Make-A-Pede/Make-A-Pede-Website/README.md

# Make-A-Pede-Website
Files for the Make-A-Pede website: http://makeapede.com
