Make-A-Pede/Make-A-Pede-Website/deck.js-latest/themes/style/metal-tile-d.jpg

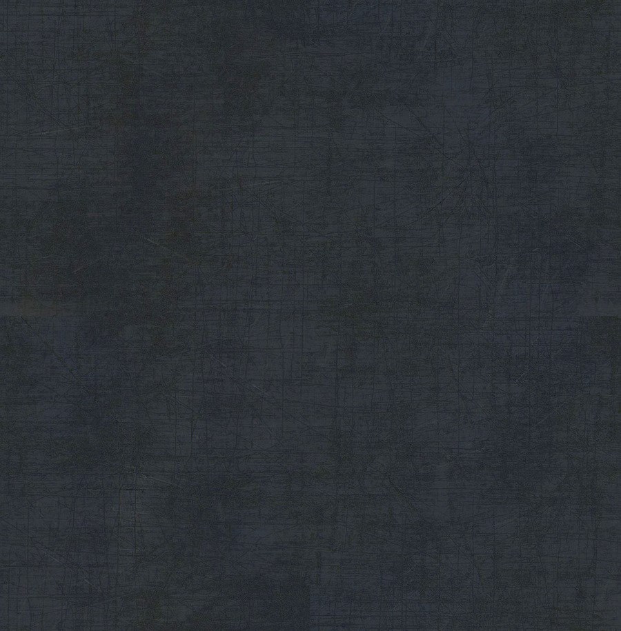
deck.js-latest/themes/style/metal-tile-d.jpg
