Make-A-Pede/Make-A-Pede-Website/img/arduino-community.png

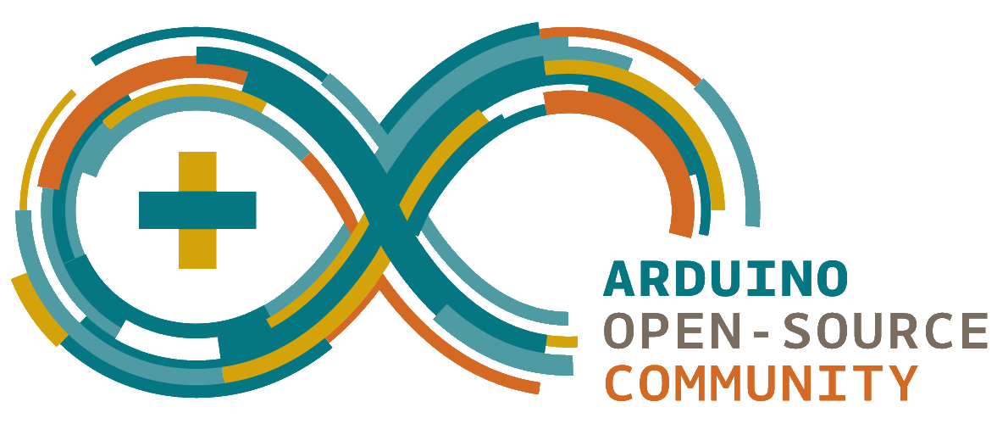
img/arduino-community.png
