Make-A-Pede/Make-A-Pede-Website/img/electronics101.png

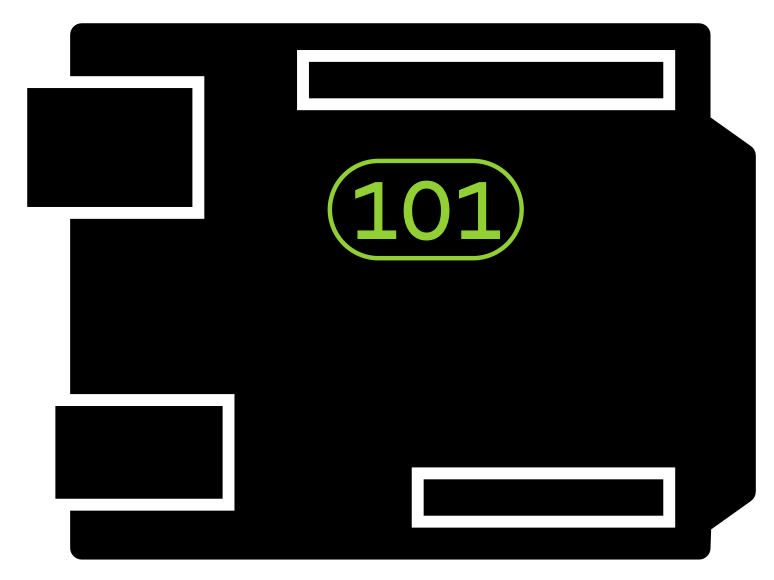
img/electronics101.png
