Make-A-Pede/Make-A-Pede-Website/img/hackadayio.png

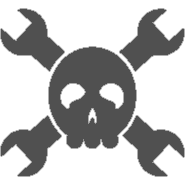
img/hackadayio.png
