Make-A-Pede/Make-A-Pede-Website/img/IMG_20170712_092057252_edited2.jpg

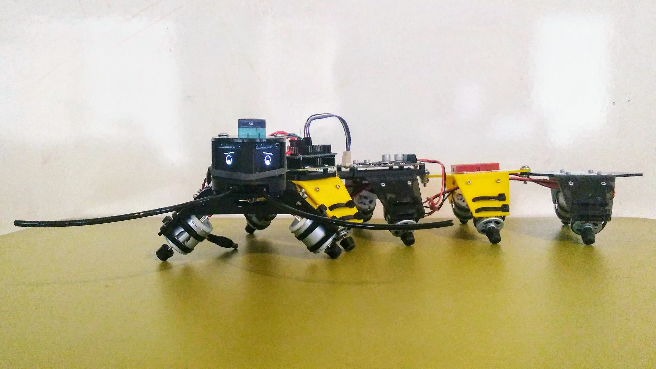
img/IMG_20170712_092057252_edited2.jpg
