Make-A-Pede/Make-A-Pede-Website/img/IMG_20170712_092200675_edited_w.jpg

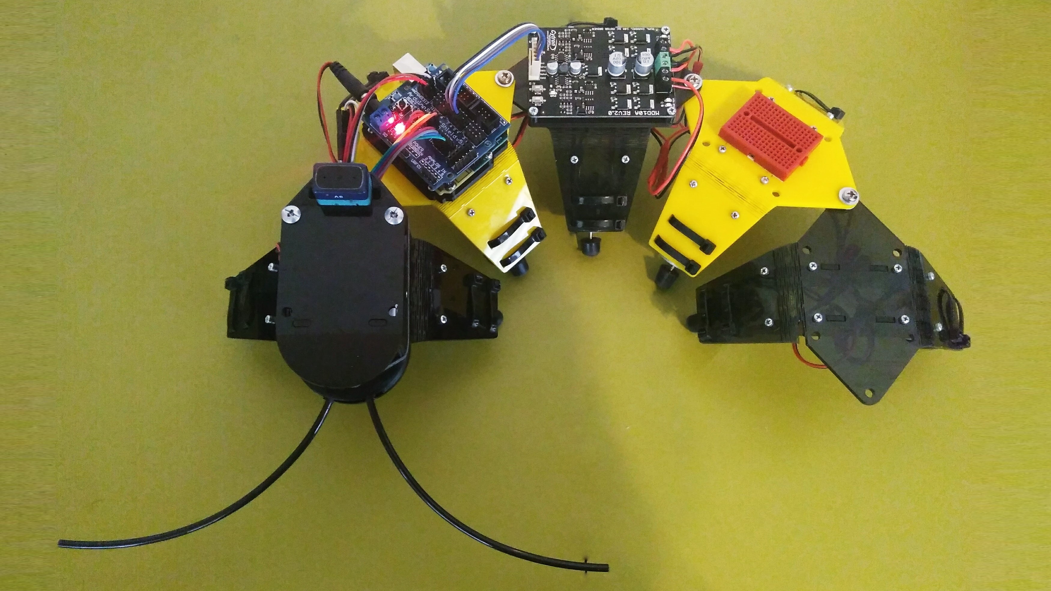
img/IMG_20170712_092200675_edited_w.jpg
