Make-A-Pede/Make-A-Pede-Website/img/map-mascot-dg.png

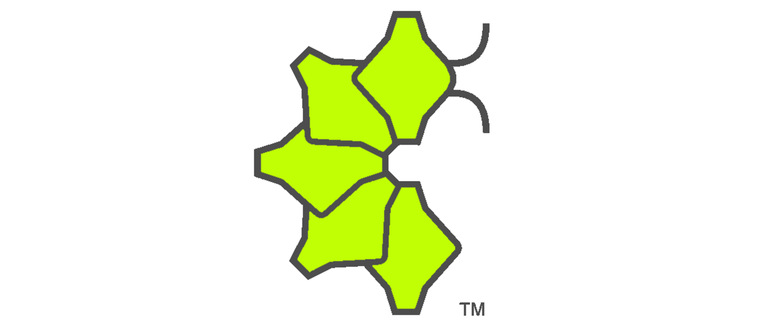
img/map-mascot-dg.png
