Make-A-Pede/Make-A-Pede-Website/img/overview3.png

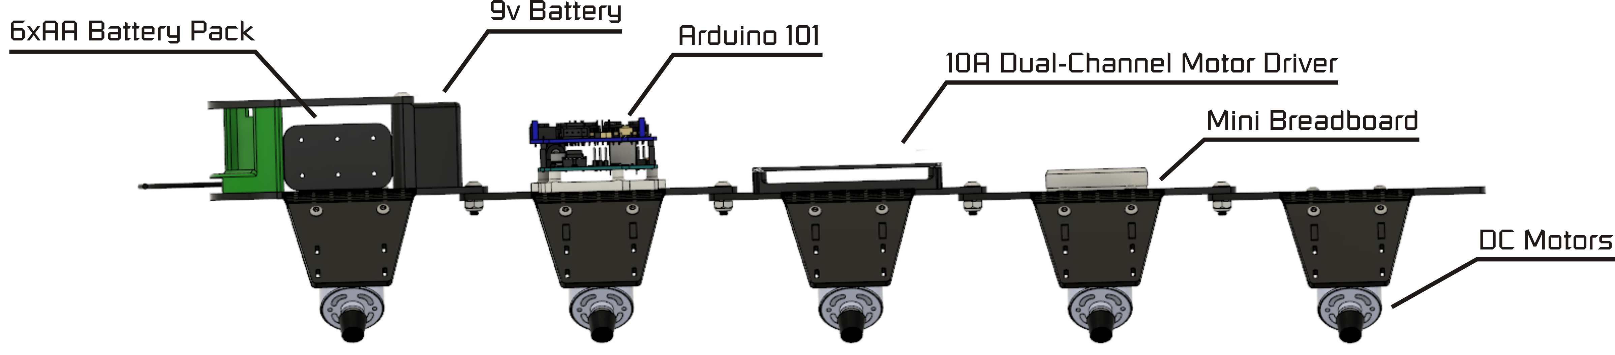
img/overview3.png
