Make-A-Pede/Make-A-Pede-Website/img/programming.png

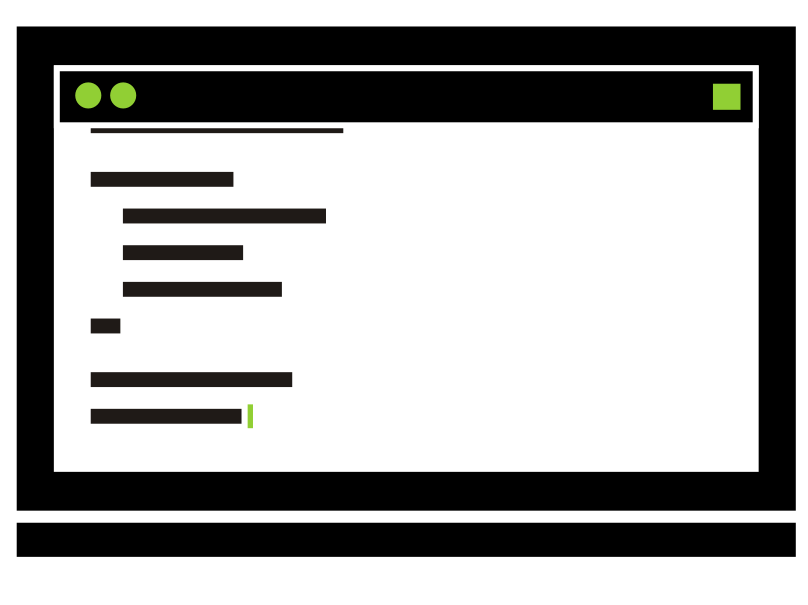
img/programming.png
