Make-A-Pede/Make-A-Pede-Website/img/render3.jpg

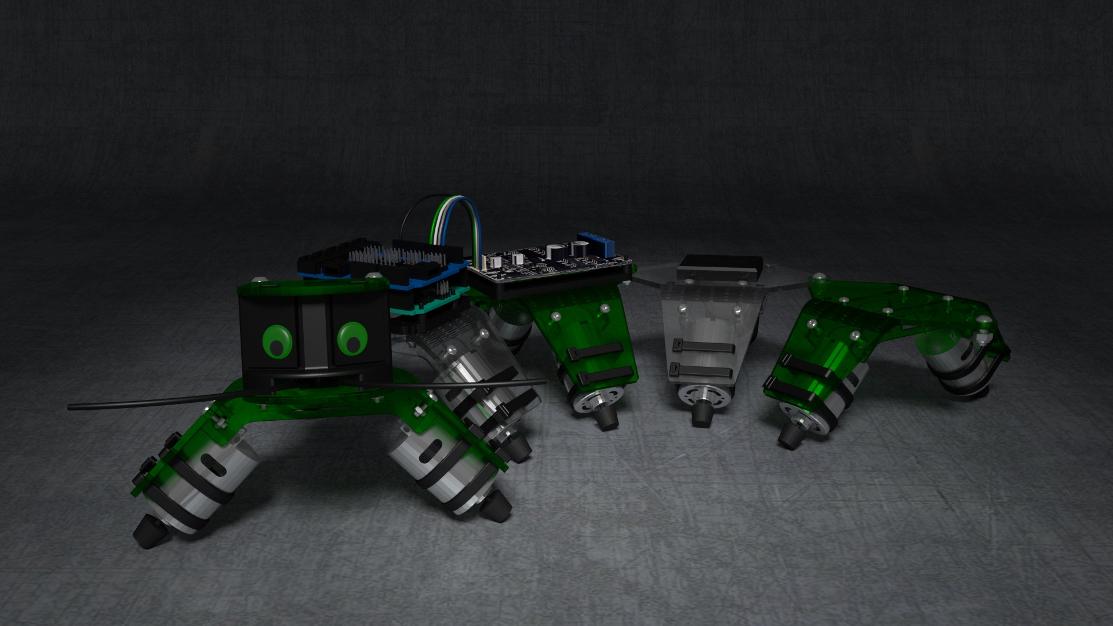
img/render3.jpg
