Make-A-Pede/Make-A-Pede-Website/img/render.jpg

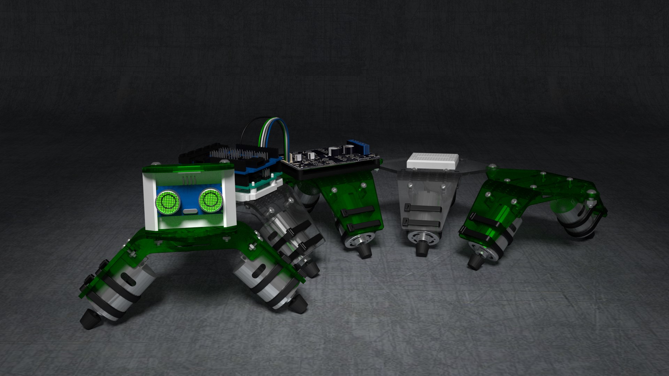
img/render.jpg
