Make-A-Pede/Make-A-Pede-Website/plans/MaP-Controller-v1.1.0.jpg

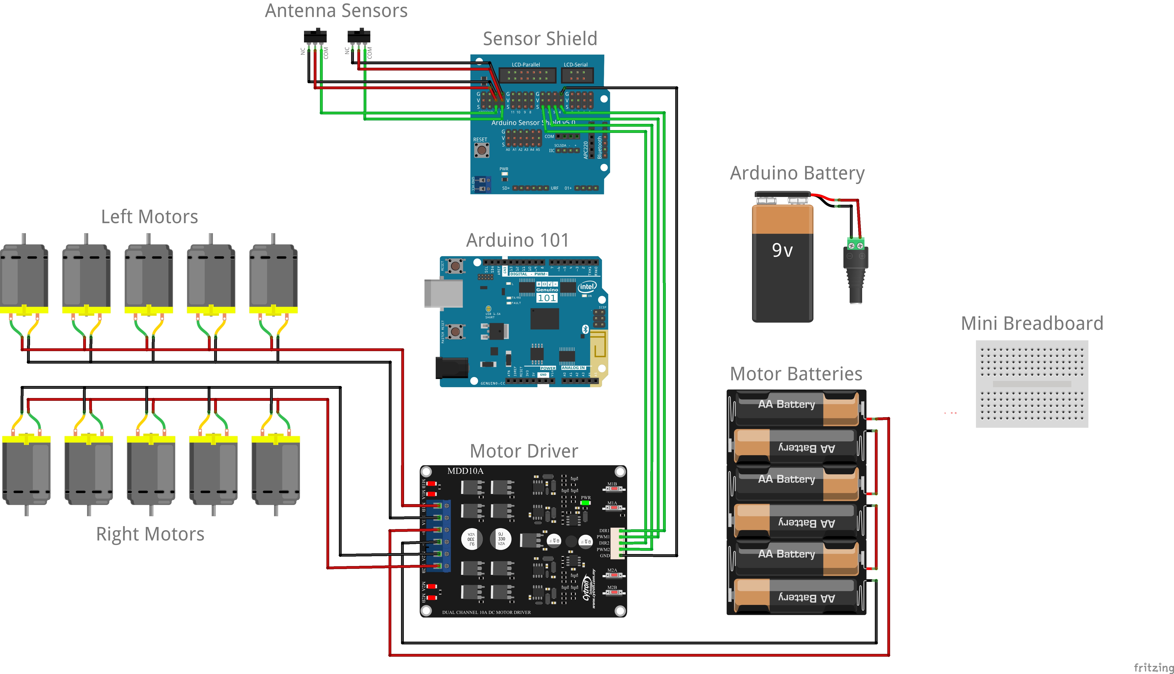
plans/MaP-Controller-v1.1.0.jpg
