Make-A-Pede/Make-A-Pede-Website/starthere/img/app.jpg

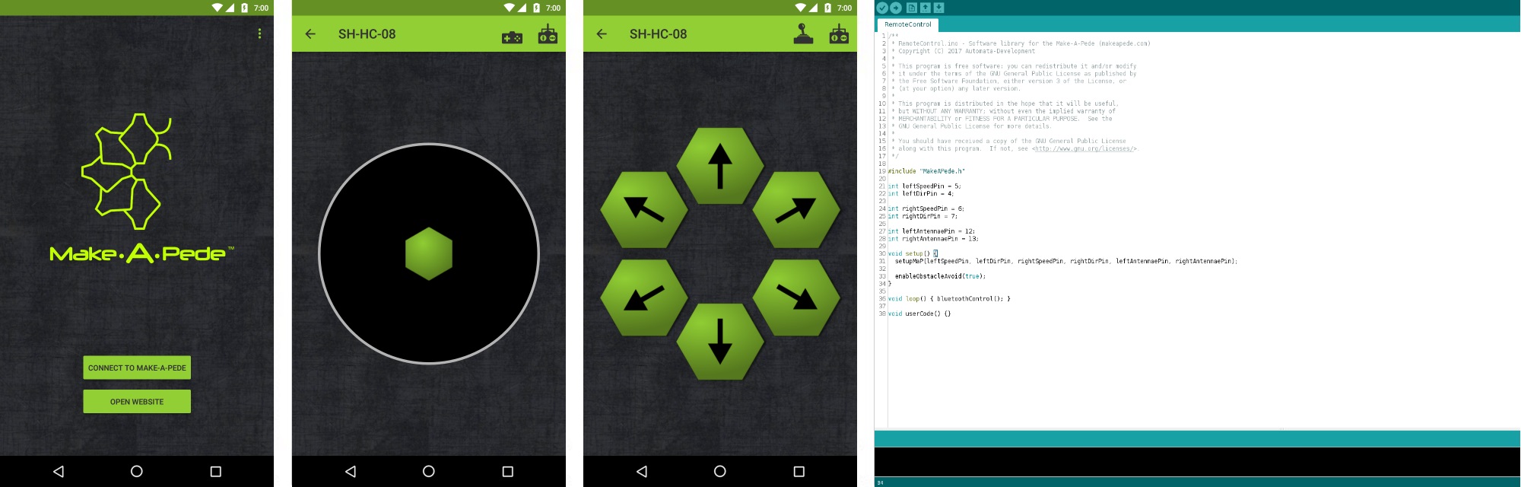
starthere/img/app.jpg
