Make-A-Pede/Make-A-Pede-Website/starthere/img/arrows.png

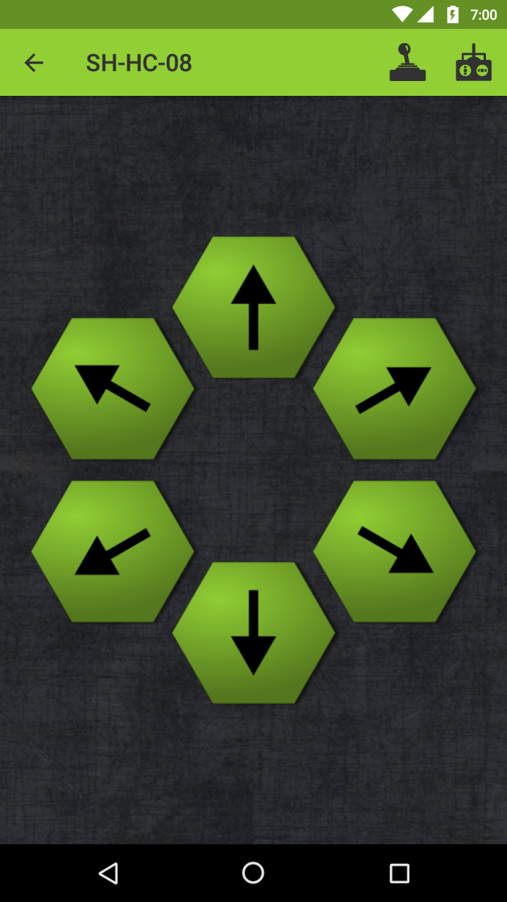
starthere/img/arrows.png
