Make-A-Pede/Make-A-Pede-Website/starthere/img/headsegment.jpg

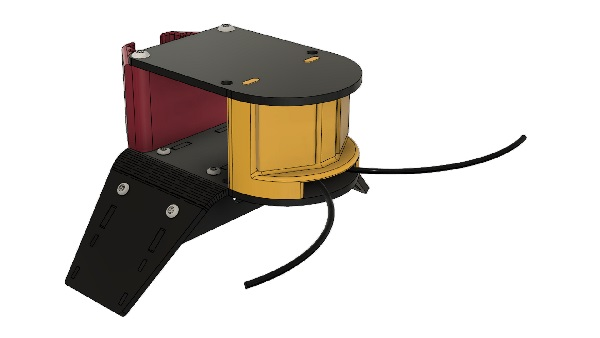
starthere/img/headsegment.jpg
