Make-A-Pede/Make-A-Pede-Website/starthere/img/home.png

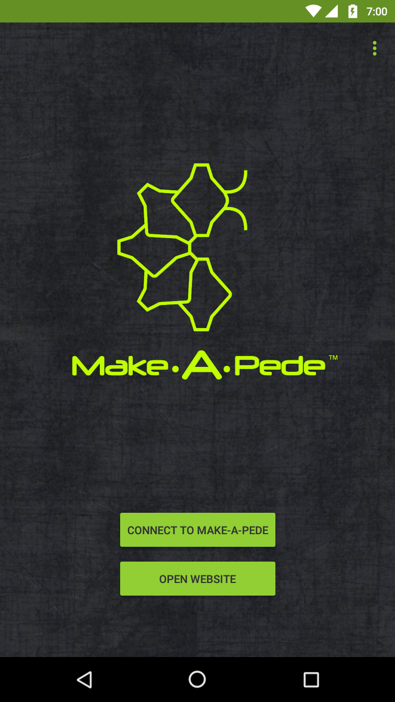
starthere/img/home.png
