Make-A-Pede/Make-A-Pede-Website/starthere/img/IMG_20170526_203459872_edited.jpg

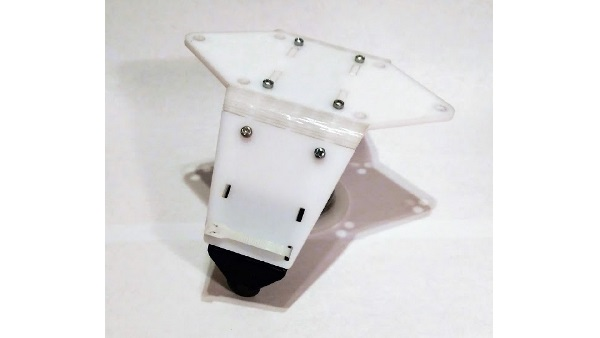
starthere/img/IMG_20170526_203459872_edited.jpg
