Make-A-Pede/Make-A-Pede-Website/starthere/img/IMG_20170526_203523421_HDR_edited.jpeg

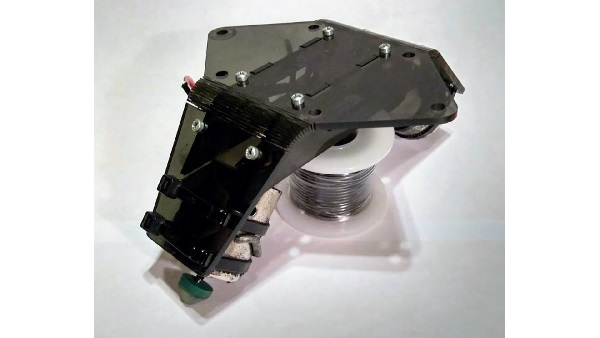
starthere/img/IMG_20170526_203523421_HDR_edited.jpeg
