Make-A-Pede/Make-A-Pede-Website/starthere/img/IMG_20170531_193209461_edited.jpg

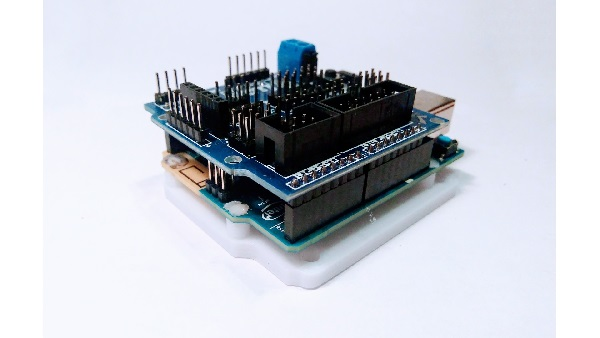
starthere/img/IMG_20170531_193209461_edited.jpg
