Make-A-Pede/Make-A-Pede-Website/starthere/img/IMG_20170531_201020182_edited.jpg

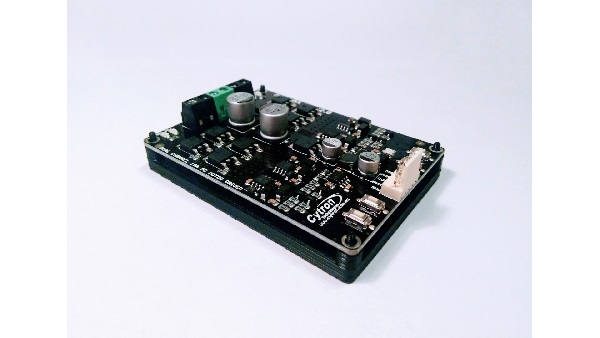
starthere/img/IMG_20170531_201020182_edited.jpg
