Make-A-Pede/Make-A-Pede-Website/starthere/img/joystick.png

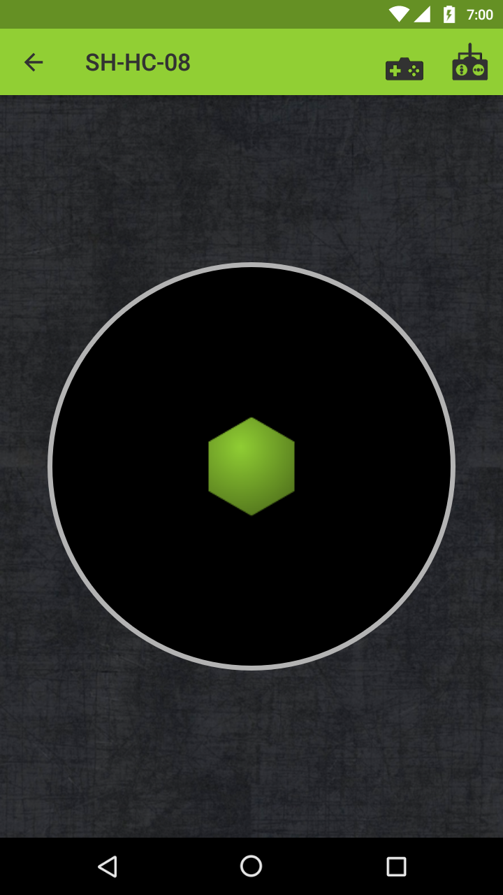
starthere/img/joystick.png
