Make-A-Pede/Make-A-Pede-Website/starthere/img/map-arduino.png

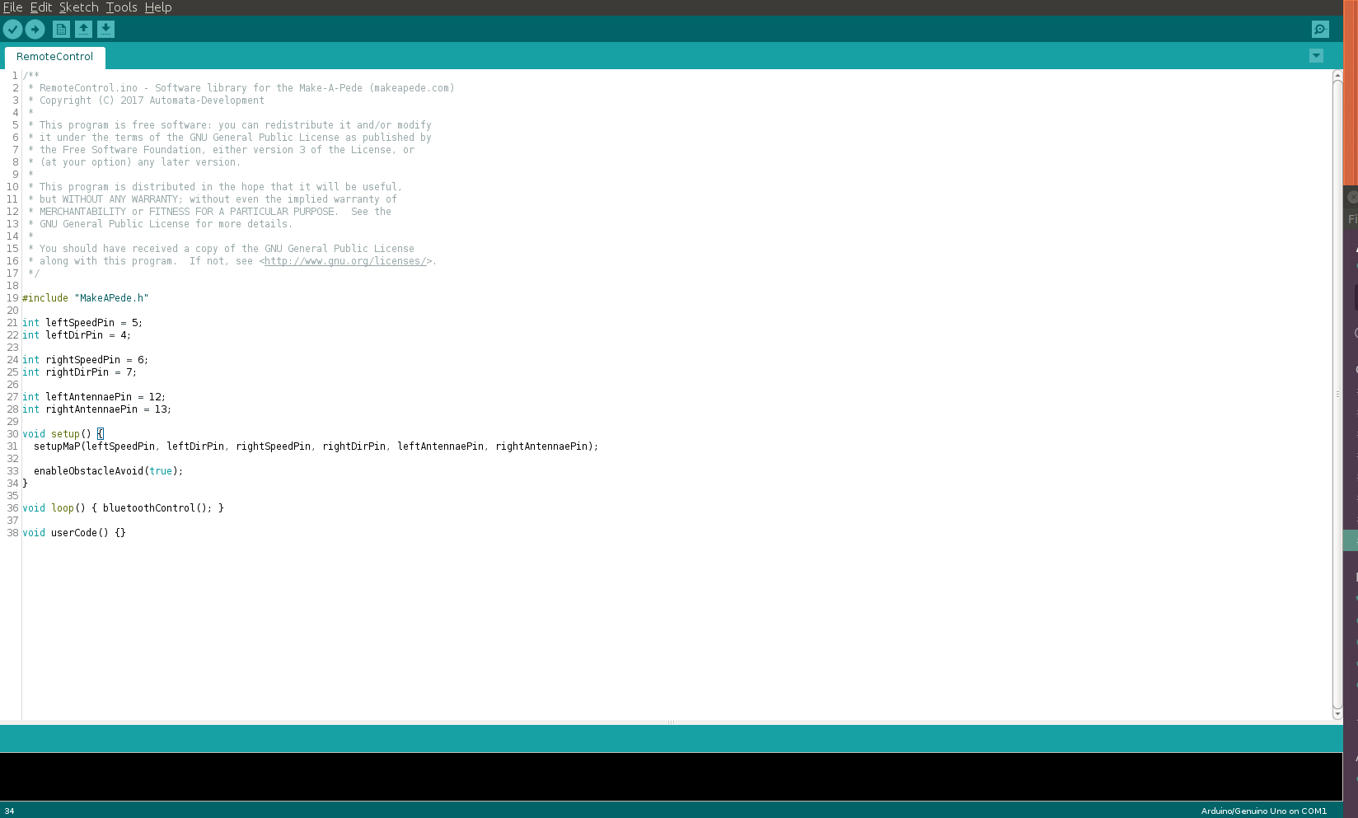
starthere/img/map-arduino.png
