Make-A-Pede/Make-A-Pede-Website/starthere/img/sensormounting.jpg

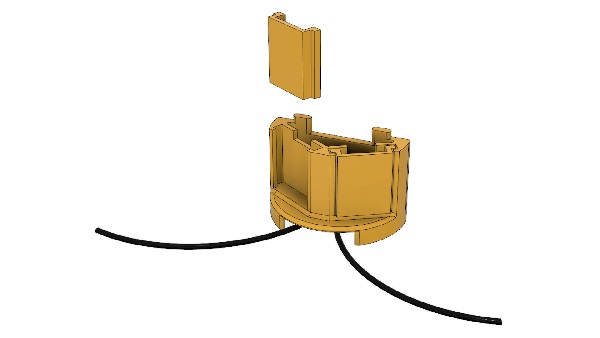
starthere/img/sensormounting.jpg
