Make-A-Pede/Make-A-Pede-Website/buildyourownrobot/index.html

# Home

- About
- Why
- Getting Started
- Going Further

# Start Here

- Get the Parts
- Build the Chassis
- Wire the Electronics
- Write a Program

# Plans

- Bill of Materials
- CAD Files
- Schematics
- Code Library

# Tutorials

- Building
- Programming
- Projects

# Store (http://store.makeapede.com/)

# Build Your Own Robot

Instructions and resources for the Build Your Own Robot class offered at the 2019 AFHE Convention. When completed, this robot will autonomously drive around and avoid obstacles.

Building Instructions

Programming Instructions

GitHub Repository (https://github.com/Make-A-Pede/AFHE-Beginning-Robotics-Workshop)

Click on the bars in the upper right corner to show all videos in playlist

### Updates

7/19/2019

- When mounting the servo horn, the small screws used have been known to break. You can avoid this by only putting the screws in about 1/2 of the way. If the screws do break, you can add superglue to hold the parts in place.
- If one of your robot's wheels runs backwards when the robot is first turned on, you can swap the black and red wires going into the motor driver that are coming from that motor.
- To turn on your robot, install all of the batteries then plug in the Arduino. It will immediately start running the program you loaded. To turn off the robot, unplug the Arduino, then remove one of the batteries.
- This kit does not include the electronic components needed for the robot to be controlled using our app. However, this is a low cost upgrade you can do yourself and we will be posting more details here soon.

7/30/2019

Bluetooth remote control can be added to your robot using an HC-08 bluetooth module. These modules are included with the Make-A-Pede kit or can be purchased from Amazon (e.g. DSD TECH SH-HC-08 Bluetooth Module (https://www.amazon.com/DSD-TECH-SH-HC-08-Transceiver-Compatible/dp/B01N4P7T0H/)).

Adding Bluetooth Remote Control

1. Download the remote control program here
2. Load the program on your robot using the same procedure as shown in the videos/instructions above
3. After the program is loaded, attach the Bluetooth module to your robot as shown below.
4. Follow the instructions in this video to set up the app: Make-A-Pede Phone Connection and First Run (https://youtu.be/nE9ZWOvrAX8?t=70)
5. You will need to disconnect the Bluetooth module when loading a new program

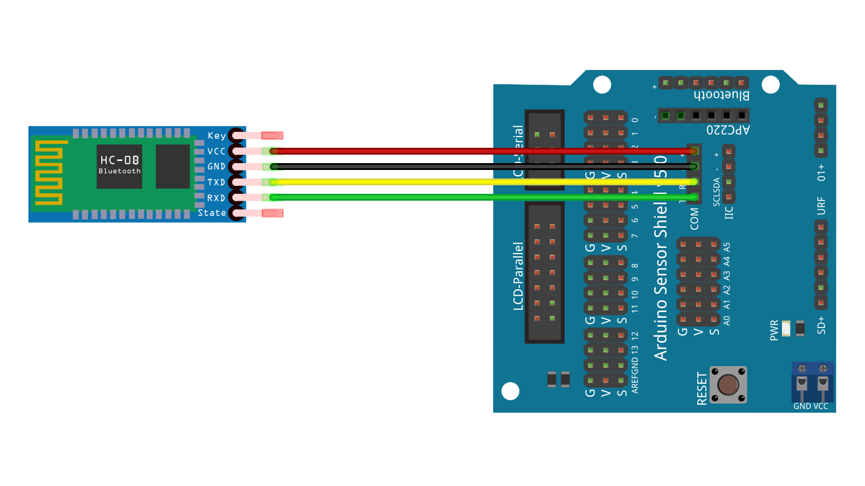
[picture p25: buildyourownrobot/bluetooth-wiring.png]
Bluetooth module wiring diagram


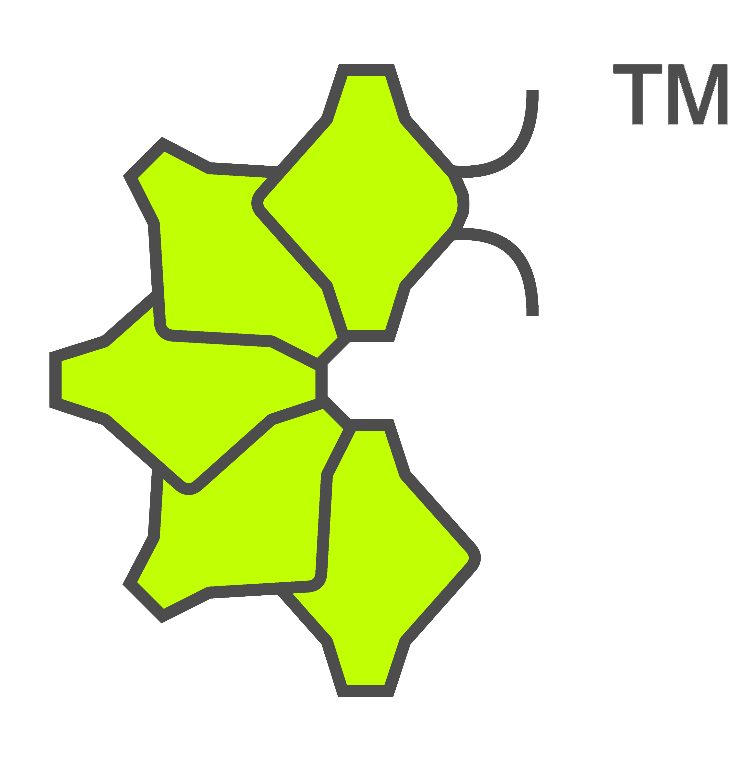
[picture p26: img/MaP-Logo-Icon-LgTM-DG.png]
Make-A-Pede Logo


(https://www.youtube.com/channel/UCuvQ2hq8uN-BKy3SVHprXtA) (https://www.facebook.com/makeapede/) (https://twitter.com/makeapede)

© 2016-2018 Automata Development
