Make-A-Pede/Make-A-Pede-Website/tutorials/index.html

# Home

- About
- Why
- Getting Started
- Going Further

# Start Here

- Get the Parts
- Build the Chassis
- Wire the Electronics
- Write a Program

# Plans

- Bill of Materials
- CAD Files
- Schematics
- Code Library

# Tutorials

- Building
- Programming
- Projects

# Store (http://store.makeapede.com/)

# Building

### Chassis Assembly Tutorials

Click on the bars in the upper right corner to show all videos in playlist

Segment Assembly Instructions

Head Segment Assembly Instructions

Segment Connection Instructions

### Electronics Installation Tutorials

Click on the bars in the upper right corner to show all videos in playlist

Motor Installation Instructions

Module Assembly Instructions

Final Wiring Instructions

Wiring Harness Assembly Instructions

# Programming

### Software Setup Tutorials

Click on the bars in the upper right corner to show all videos in playlist

Library and Remote Control Program Installation Instructions

Phone Connection and First Run Instructions

### Additional Resources

Arduino IDE (Windows) (https://www.arduino.cc/en/Guide/Windows)

Arduino IDE (mac OS) (https://www.arduino.cc/en/Guide/MacOSX)

GitHub Repository (https://github.com/Make-A-Pede/Make-A-Pede-Arduino-Library)

Android App

iOS App

# Projects

### Sound Sensor

Difficulty:     

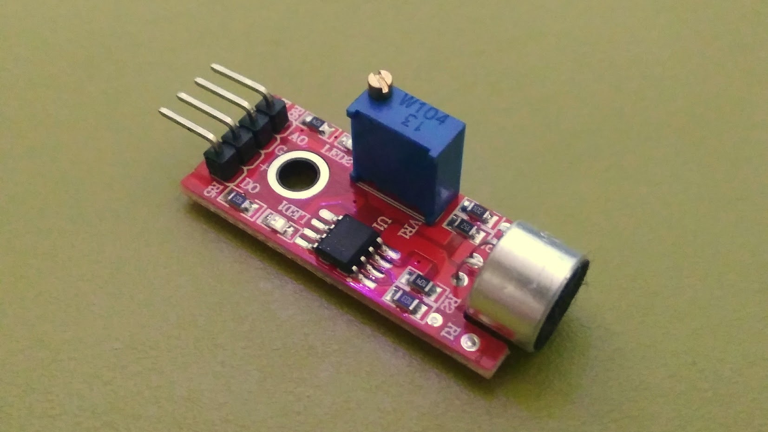
[picture p27: tutorials/projects/IMG_20170722_152200550-01[1].jpeg]


View Instructions

### IR Distance Sensor

Difficulty:     

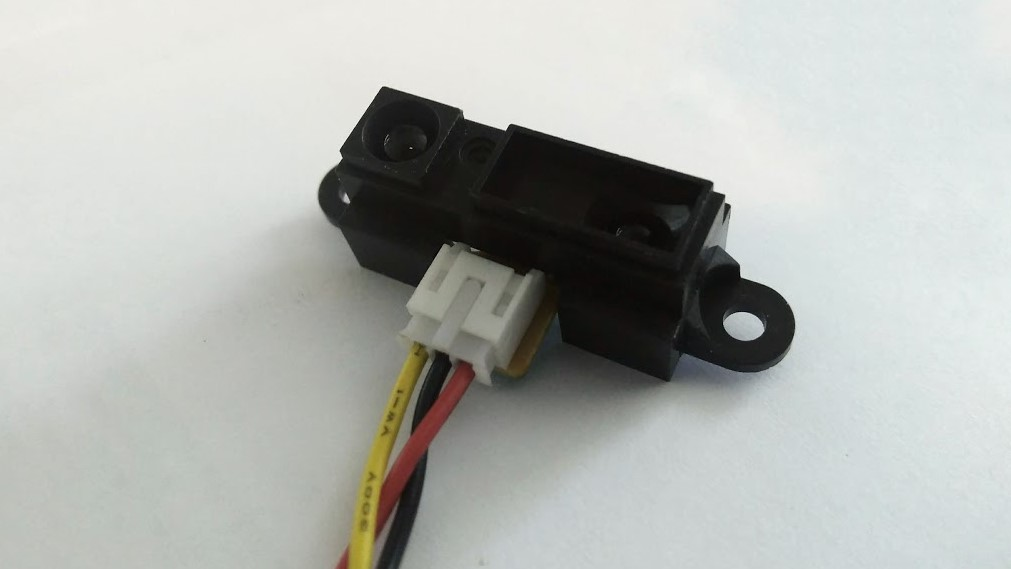
[picture p28: tutorials/projects/IMG_20180606_174354819-01.jpg]


View Instructions

### RGB LED

Difficulty:     

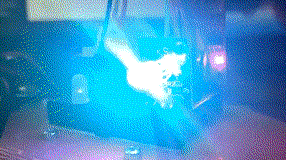
[picture p29: tutorials/projects/2017-07-22_15-47-03.gif]


View Instructions

### PIR Sensor

Difficulty:     

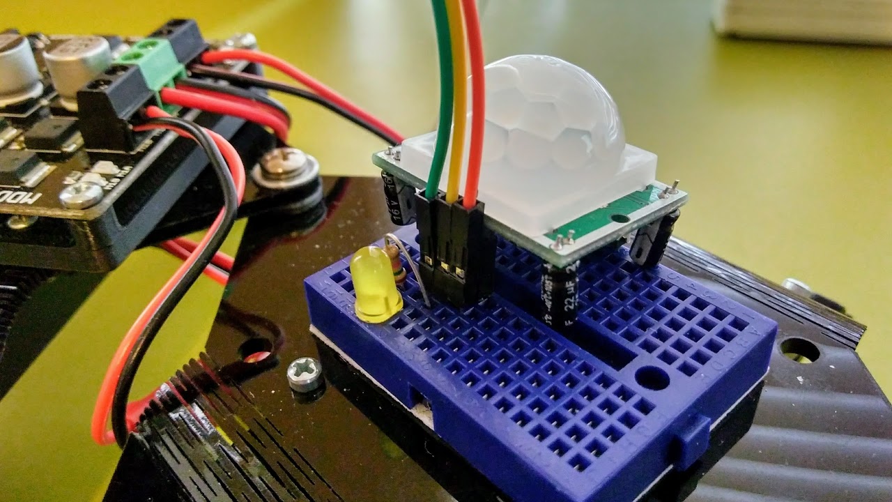
[picture p30: tutorials/projects/IMG_20170719_155303936_HDR[2].jpg]


View Instructions

### OLED Eyes

Difficulty:     

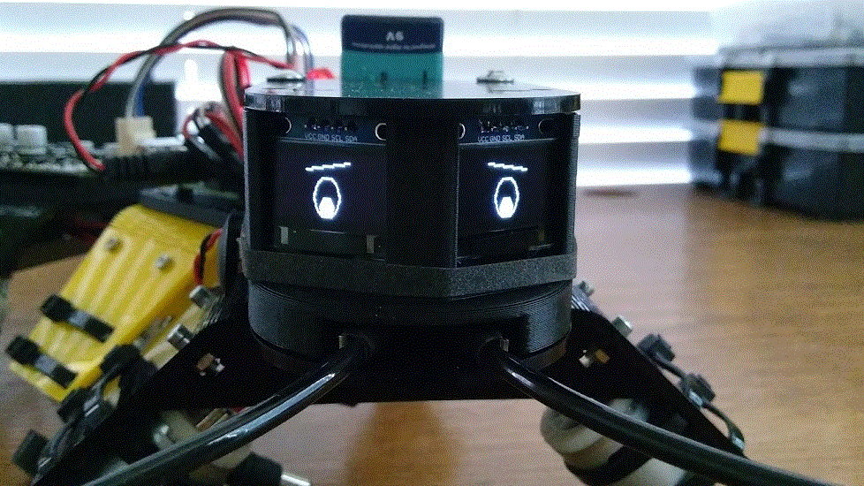
[picture p31: tutorials/projects/blinking-gif-optimized.gif]


View Instructions

### Color Sensor

Difficulty:     

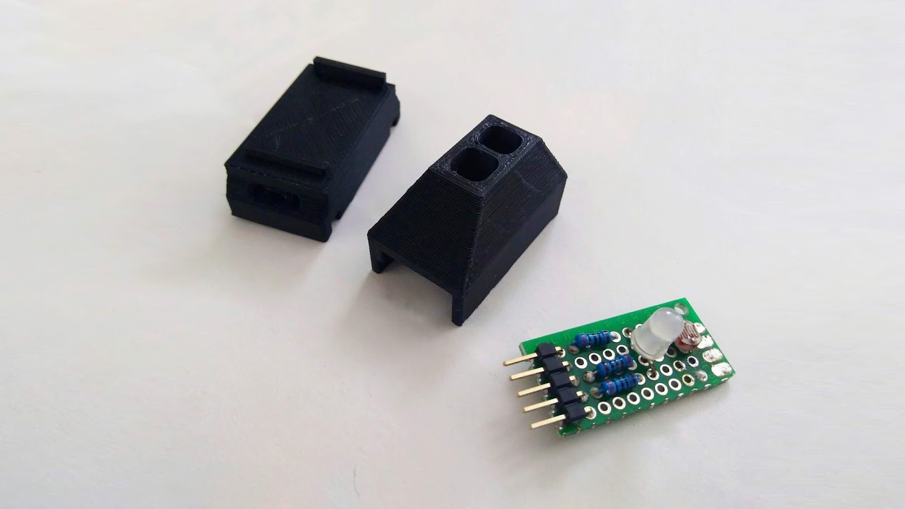
[picture p32: tutorials/projects/IMG_20180607_110257728-01.jpeg]


View Instructions

Make-A-Pede Logo

(https://www.youtube.com/channel/UCuvQ2hq8uN-BKy3SVHprXtA) (https://www.facebook.com/makeapede/) (https://twitter.com/makeapede)

© 2016-2018 Automata Development
