Make-A-Pede/Make-A-Pede-Website/tutorials/library-installation.html

# Installing the Make-A-Pede Arduino Library

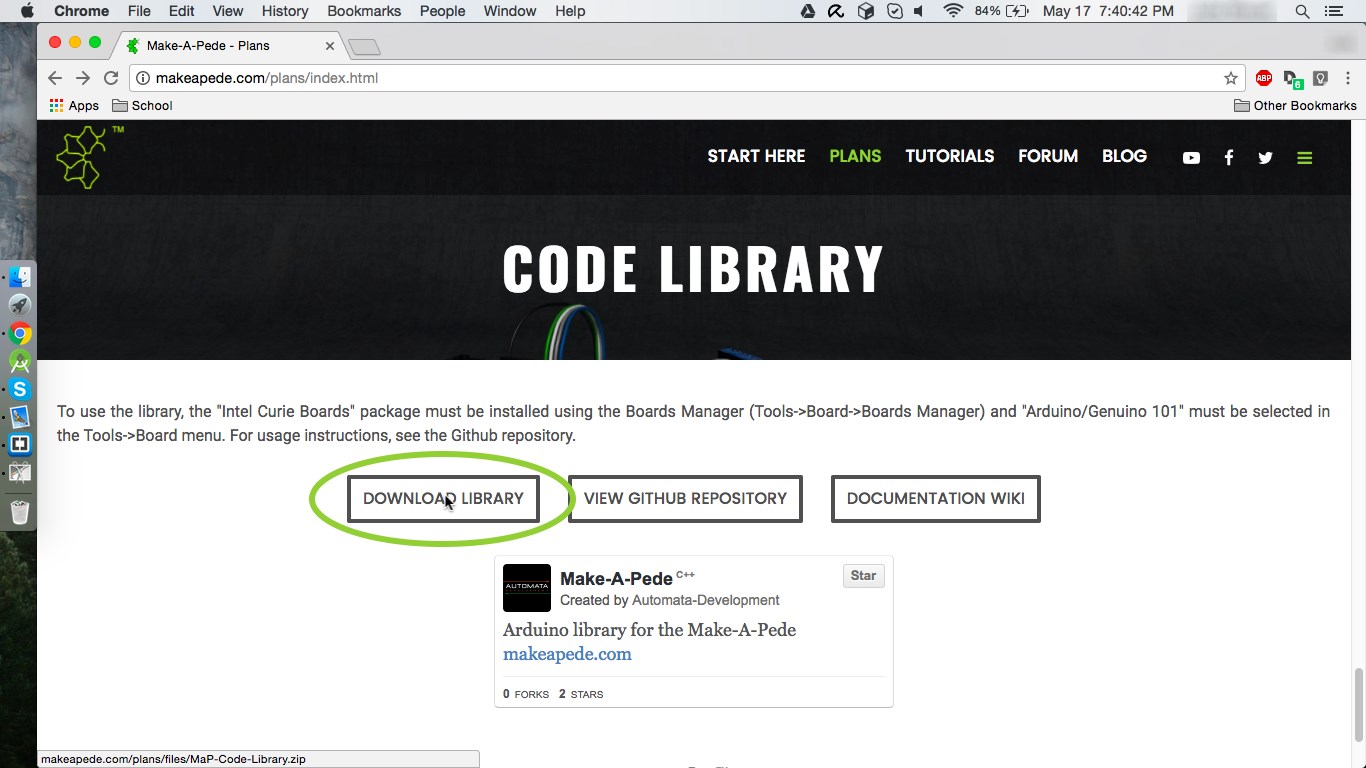
[picture p33: tutorials/installation-screenshots/9.jpg]


Download the library .zip file from the Plans page on makeapede.com and extract it.

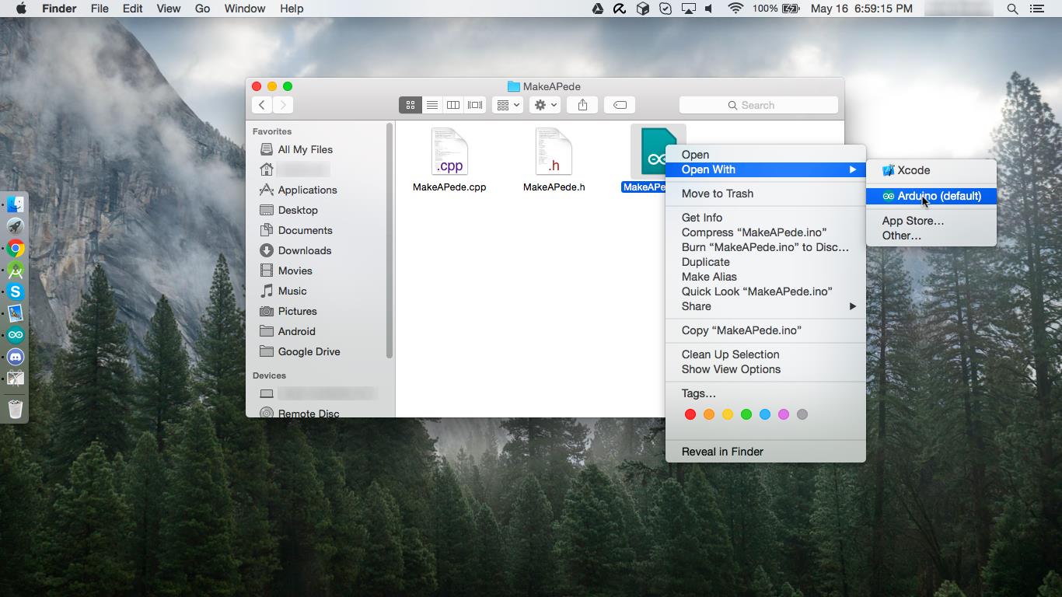
[picture p34: tutorials/installation-screenshots/3.jpg]


Open the “MakeAPede” folder and open “MakeAPede.ino” using the Arduino IDE.

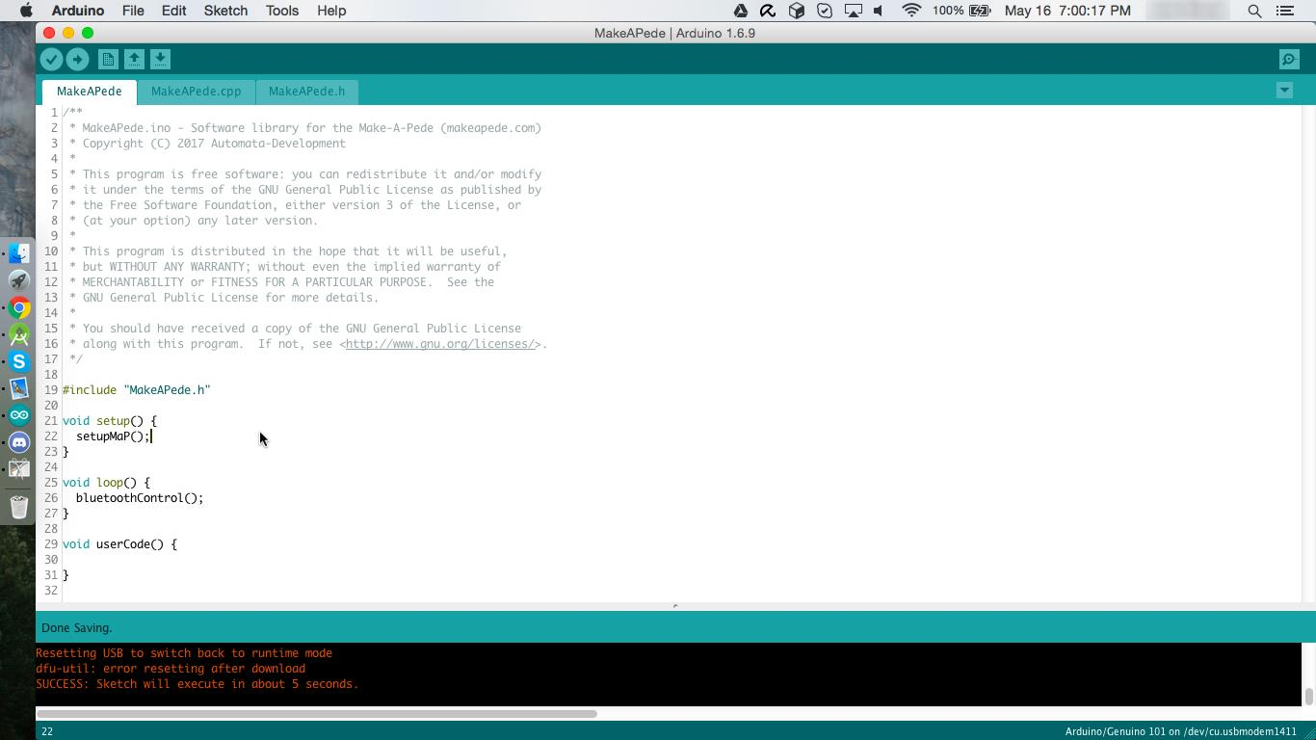
[picture p35: tutorials/installation-screenshots/4.jpg]


The project will open in the Arduino IDE. The main code will be under the “MakeAPede” tab.

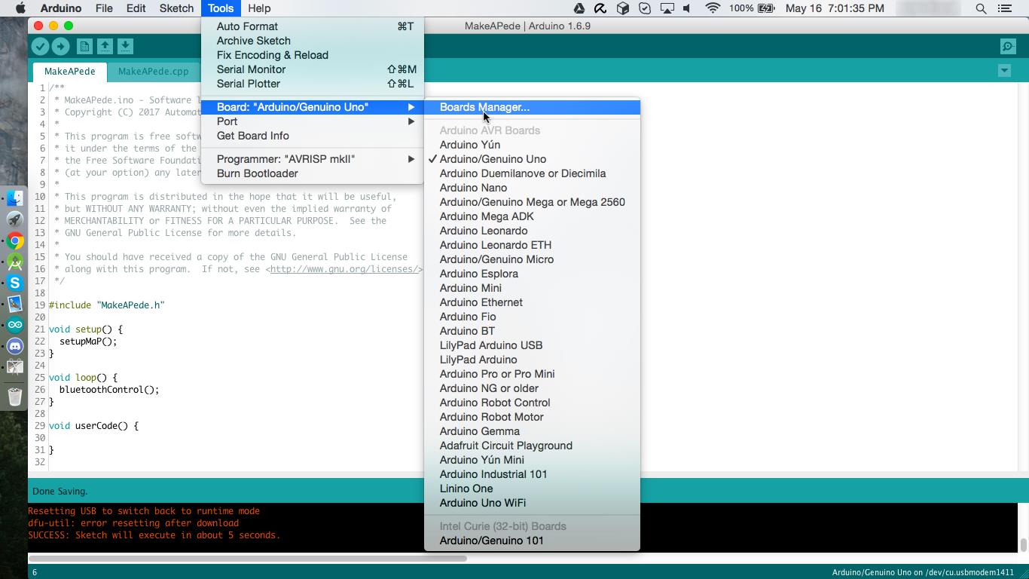
[picture p36: tutorials/installation-screenshots/5.jpg]


Go to the Tools->Board menu and open the Boards Manager.

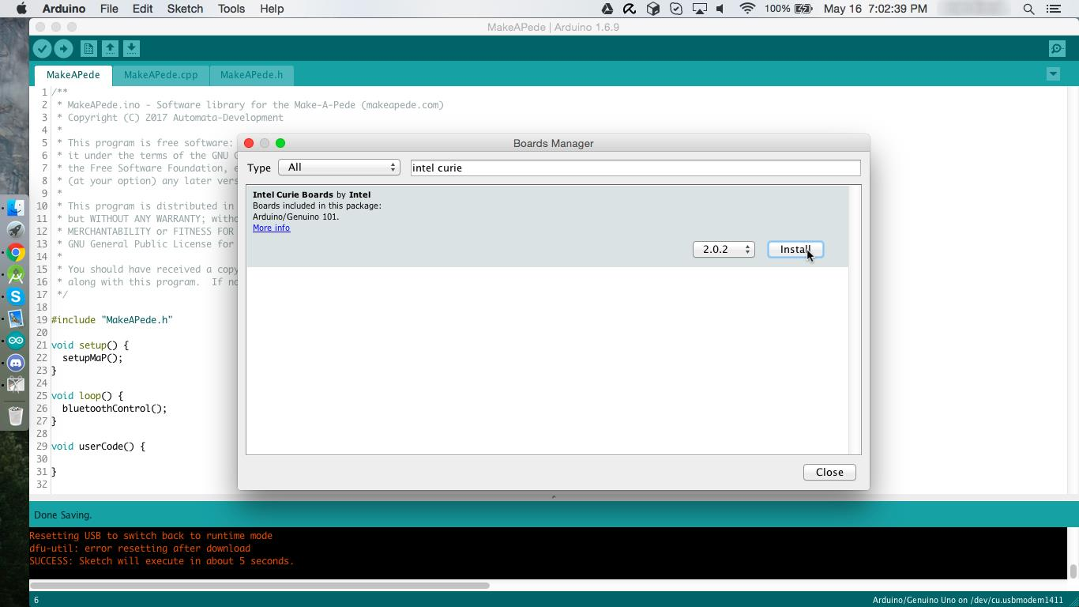
[picture p37: tutorials/installation-screenshots/6.jpg]


Search for and install the “Intel Curie Boards” package.

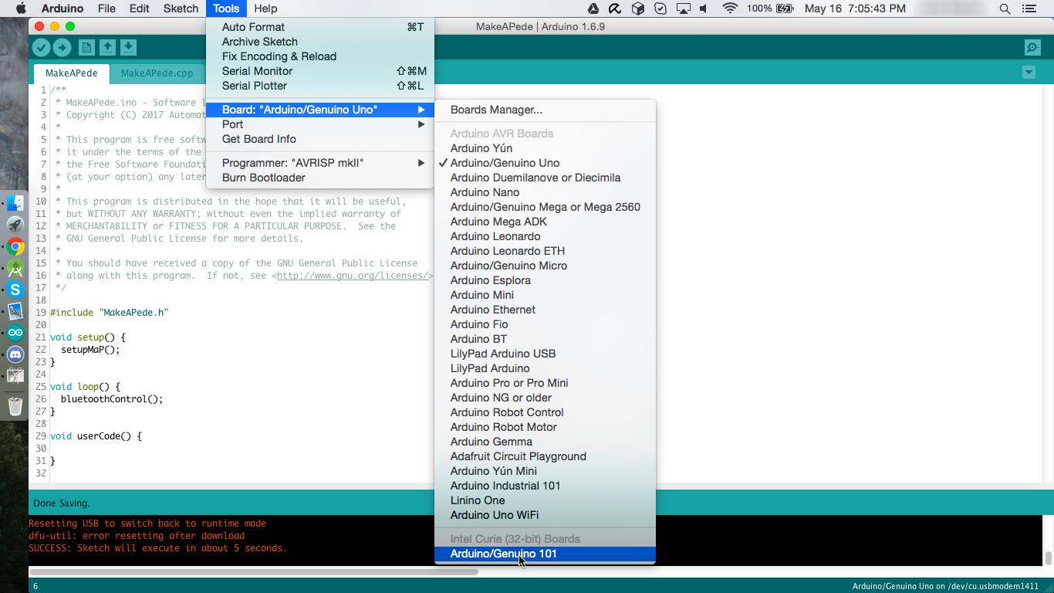
[picture p38: tutorials/installation-screenshots/7.jpg]


Once the boards package is installed, select “Arduino/Genuino 101” from the Tools->Board menu.

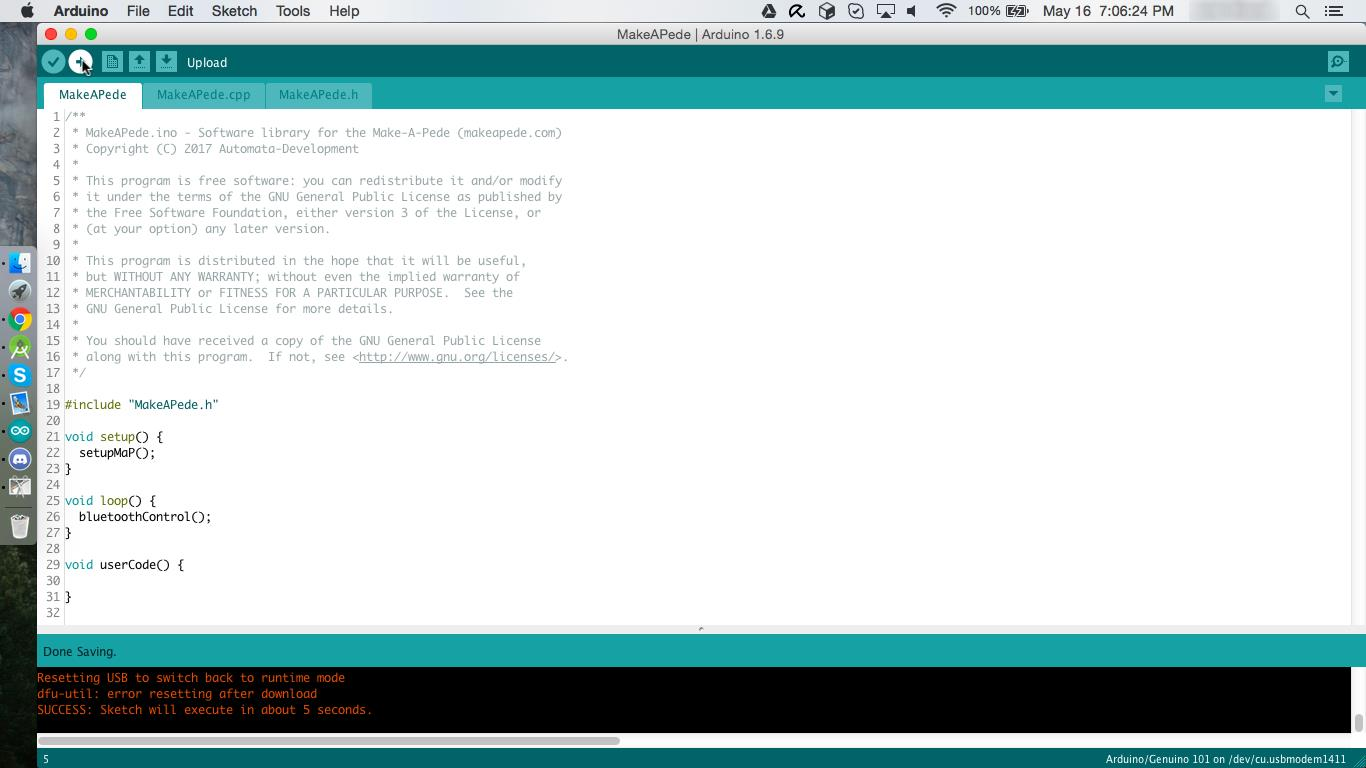
[picture p39: tutorials/installation-screenshots/8.jpg]


You can now click the upload button in the upper left corner to run the code on your robot.

← →

/
