Make-A-Pede/Make-A-Pede-Website/tutorials/projects/Project-Tutorial-Sound-Sensor.pdf

## Adding a Sound Sensor

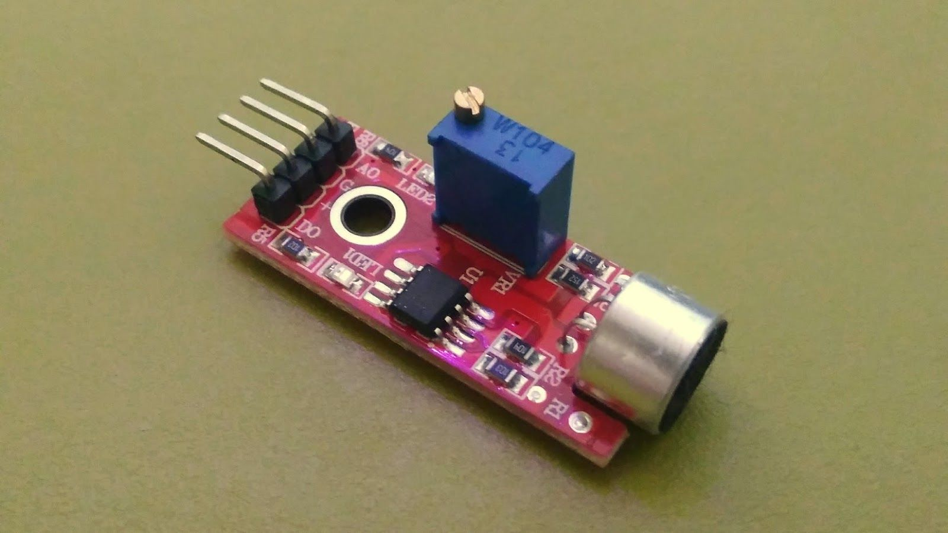
[picture p61: figure]

Parts Required:

1 - Assembled Make-A-Pede
1 - Electret Mic Breakout Board 3 - M-F Jumper Wires

### Wiring

Connect the sensor to your Make-A-Pede using the circuit shown below.

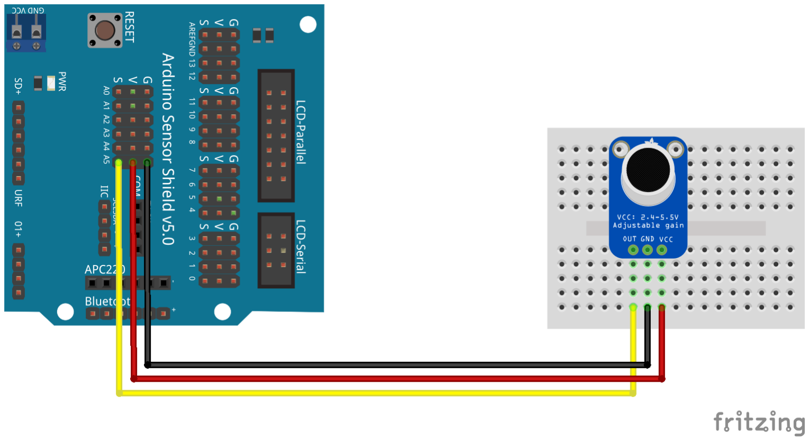
[picture p62: figure]

Be sure to check the pin labels on your specific breakout board. If your sensor has both analog and digital outputs, you only need to connect the analog output.

### Testing

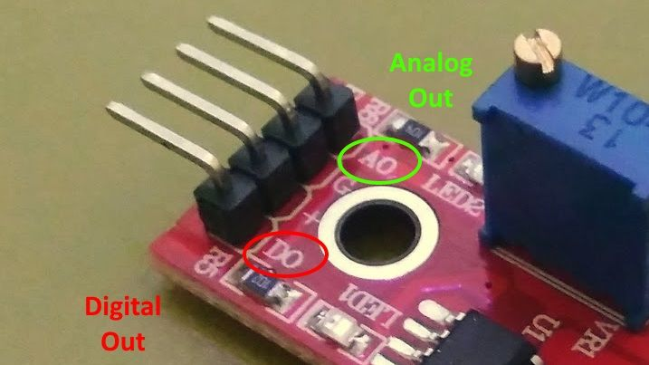
[picture p63: figure]

Plug your Arduino into your computer. Open the SoundDemo.ino program by opening the Arduino IDE and going to File → Examples → Make-A-Pede → SoundDemo. Load the program onto your Arduino.

Turn on the Make-A-Pede and trigger one of the antenna sensors to calibrate the sensor and start the program. When it detects a loud sound, your Make-A-Pede will drive around until it had bumped into 3 objects. It will then wait for you to trigger it again with another sound. If it does not stop driving to wait for another sound, try re-calibrating the sensor by pressing the reset button to restart the program.
