Make-A-Pede/Make-A-Pede-Website/tutorials/manual/Instruction-Manual-Build-Modules.pdf

Build | Modules
Items | required:

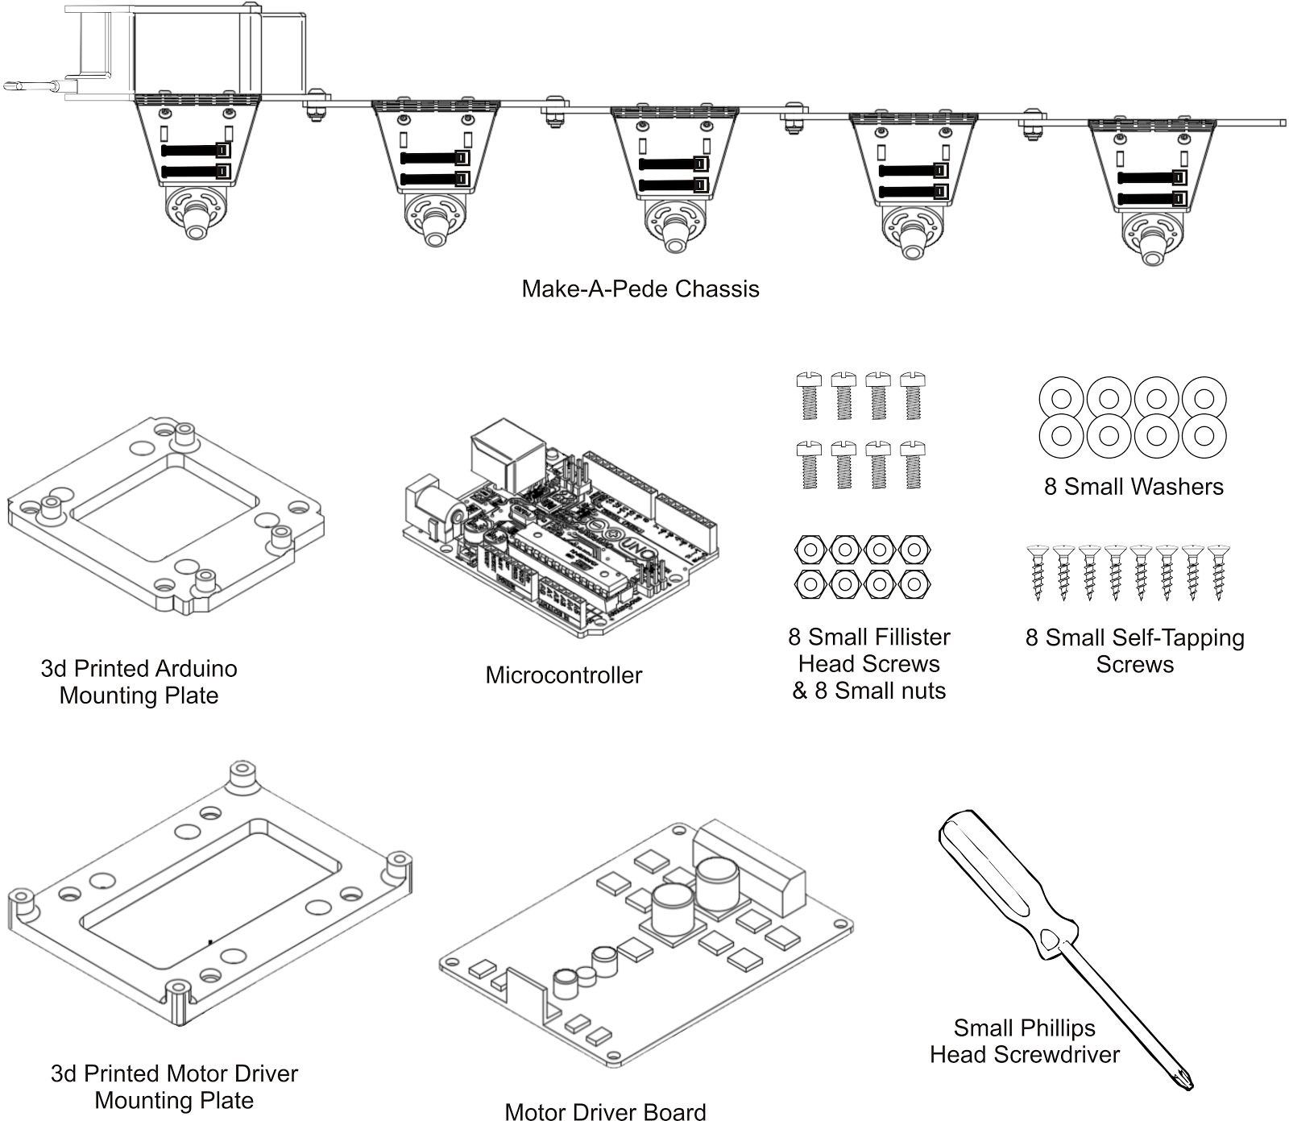
[picture p100: figure]
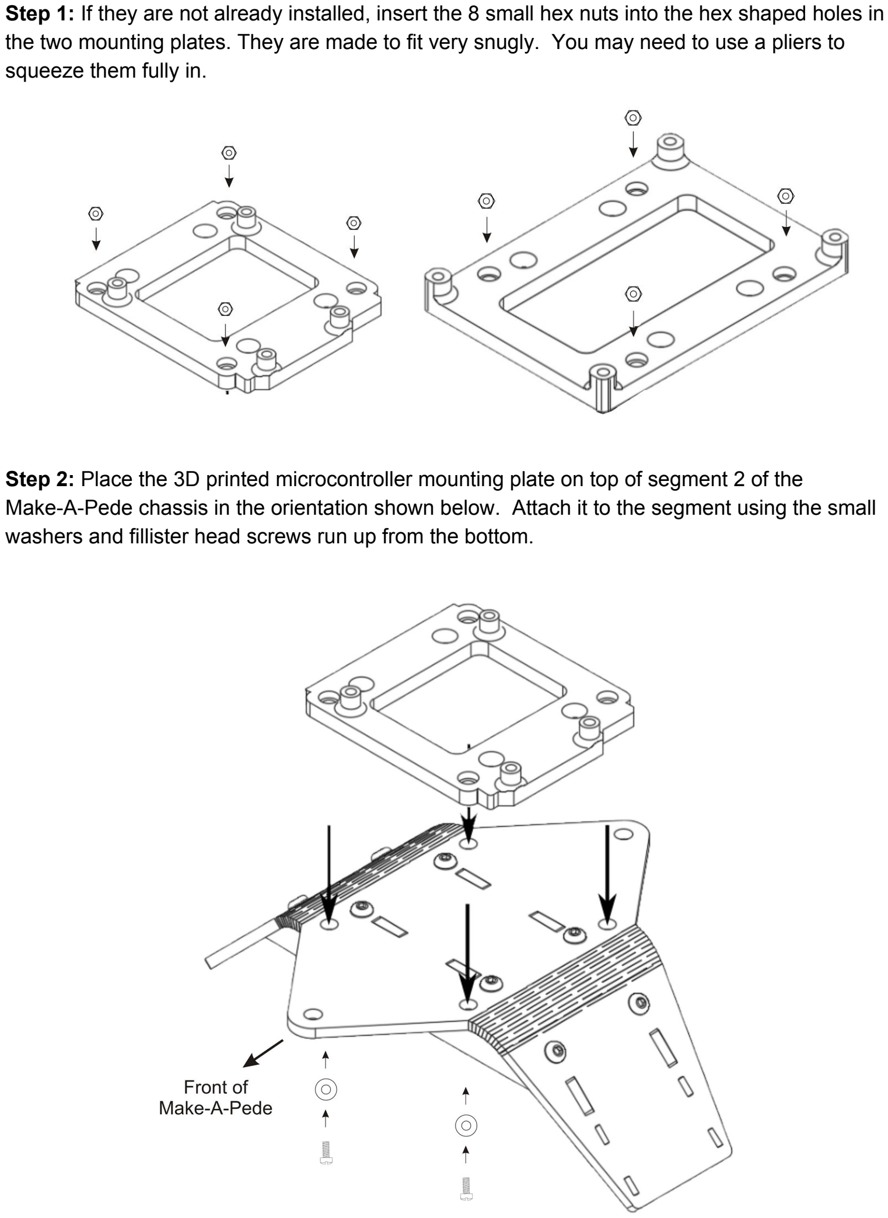
[picture p101: page 2]

Step | 1: | If they are not already installed, insert the 8 small hex nuts into the hex shaped holes in
the two mounting plates. They are made to fit very snugly. You may need to use a pliers to squeeze them fully in.
Step | 2: | Place the 3D printed microcontroller mounting plate on top of segment 2 of the
Make-A-Pede chassis in the orientation shown below. Attach it to the segment using the small washers and fillister head screws run up from the bottom.

Step | 3: | Place the microcontroller on the mounting plate in the orientation shown below. Attach
it to the mounting plate using the small self-tapping screws.

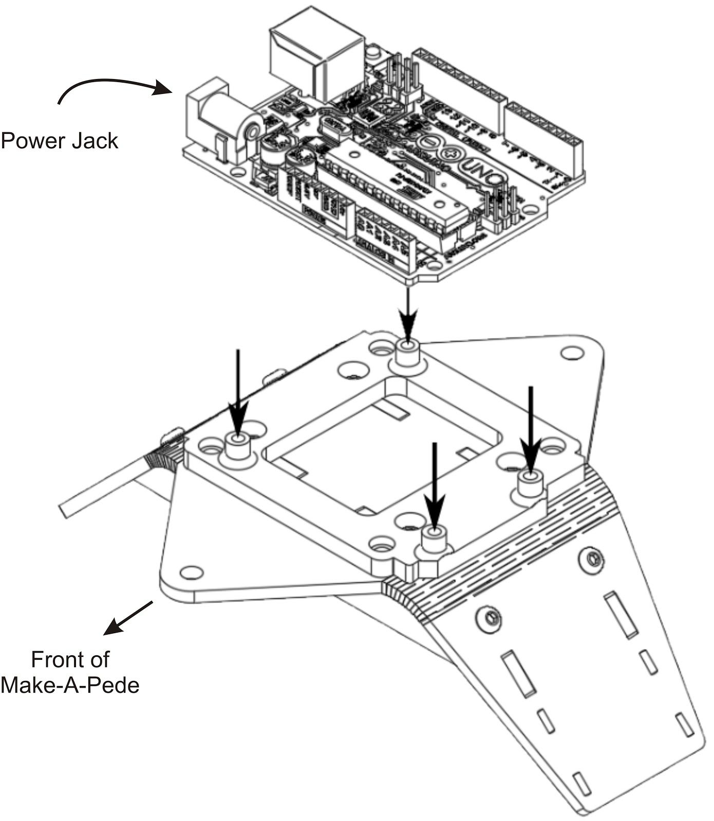
[picture p102: figure]

Step | 4: | Place the 3D printed motor driver mounting plate on top of segment 3 of the
Make-A-Pede chassis in the orientation shown below. Attach it to the segment using the small washers and fillister head screws run up from the bottom.

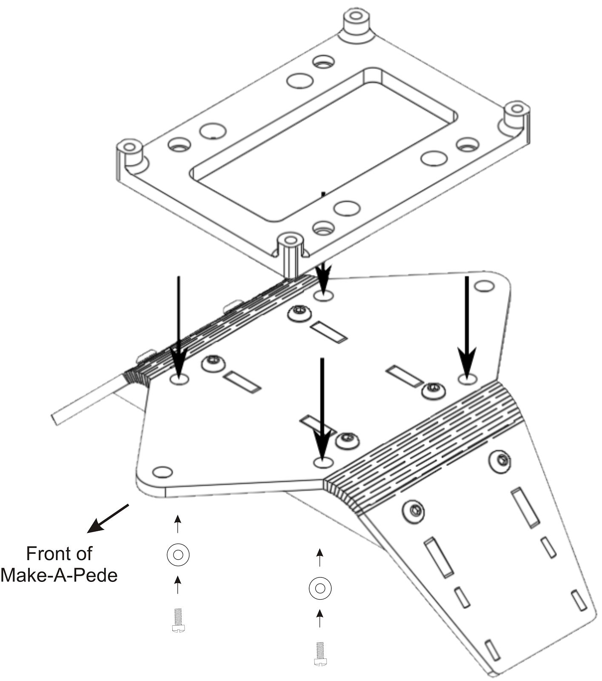
[picture p103: figure]

Step | 5: | Place the motor driver board on the mounting plate in the orientation shown below.
Attach it to the mounting plate using the small self-tapping screws.

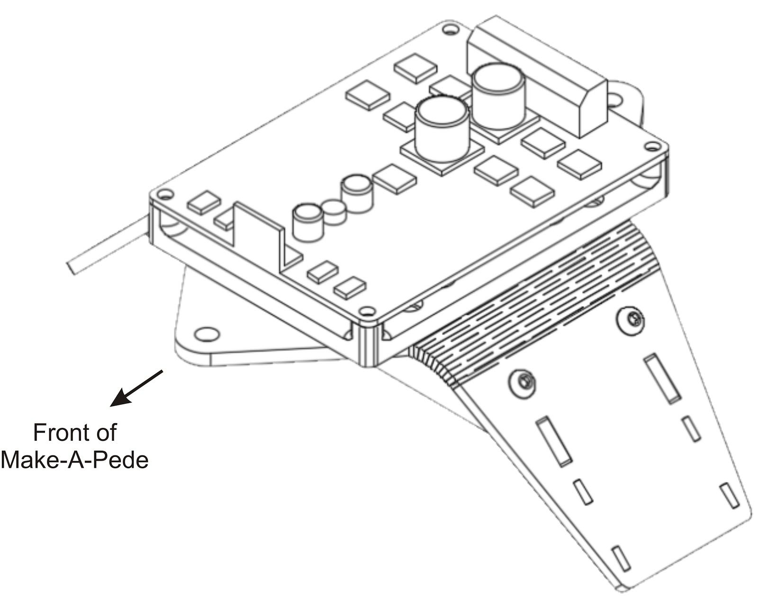
[picture p104: figure]

Step | 6: | Feed the wires from the wiring harness that go to the motor control up the sides of the
robot. Feed the left-side motor wire up to the left side and the right-side motors up to the right side (left and right are determined as if you were riding the Make-A-Pede).

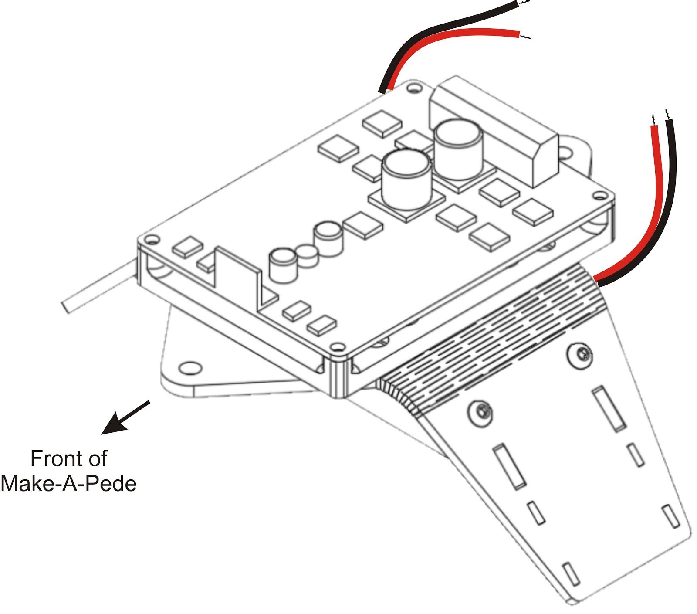
[picture p105: figure]

Step | 7: | Loosen the screw terminals on the motor driver board and insert the 4 wires in as
shown below. Tighten the screw terminals until snug.

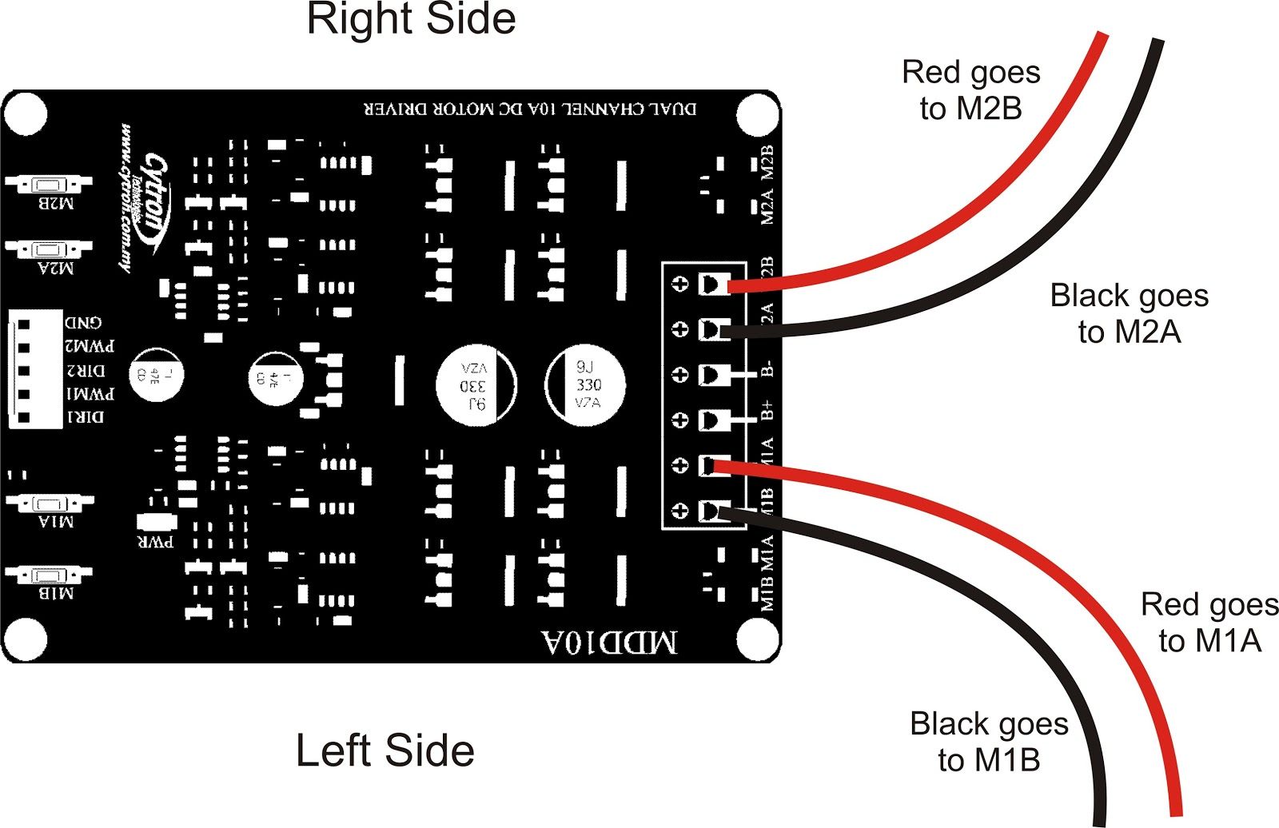
[picture p106: figure]
