Make-A-Pede/Make-A-Pede-Website/tutorials/manual/Instruction-Manual-Head-Segment-Assembly.pdf

Head | Segment | Assembly
Items | required:

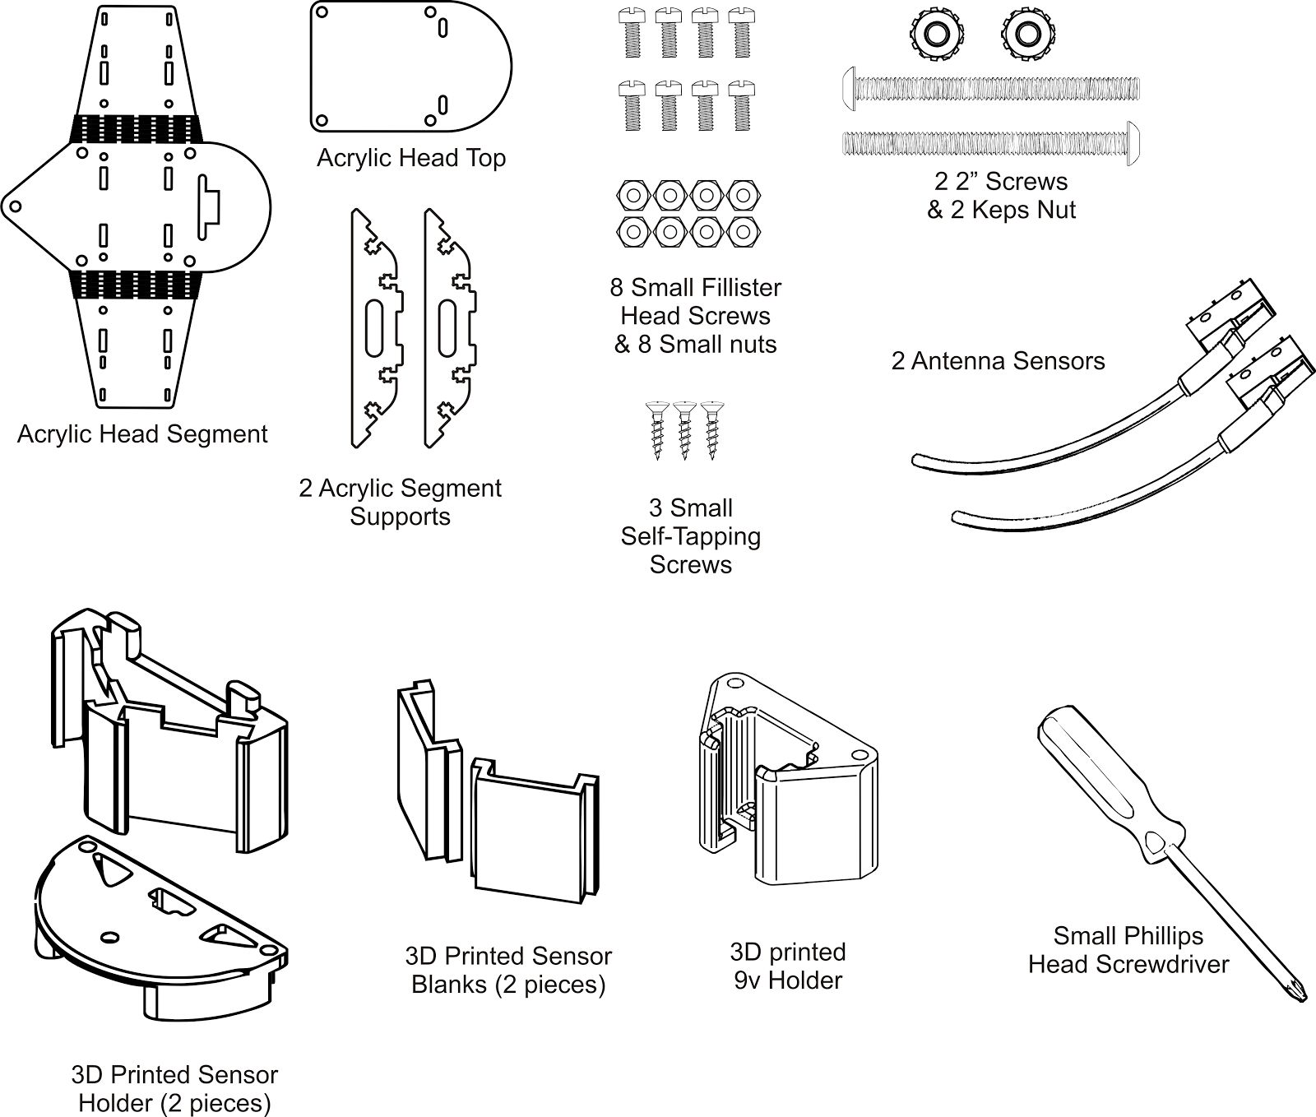
[picture p107: figure]

Step | 1: | Remove paper from all acrylic as described in Segment Assembly section. Using the
flat acrylic head segment, segment supports, small screws and nuts, assemble segment base as described in the Segment Assembly section.

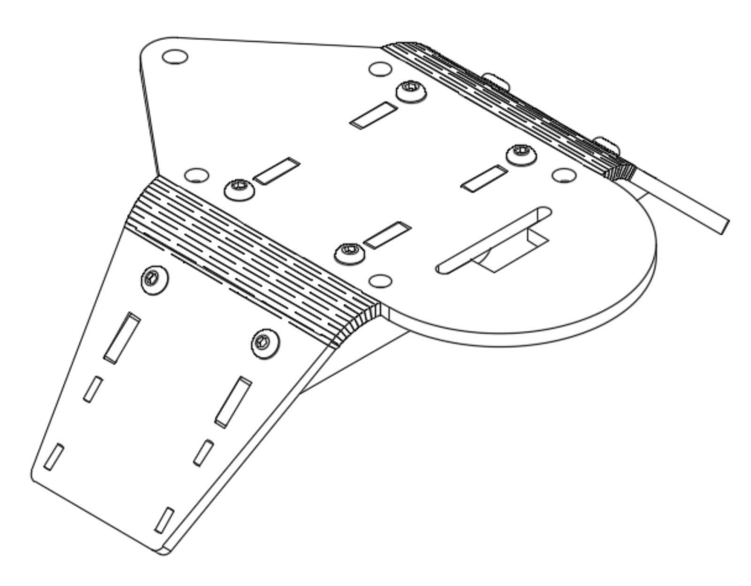
[picture p108: figure]
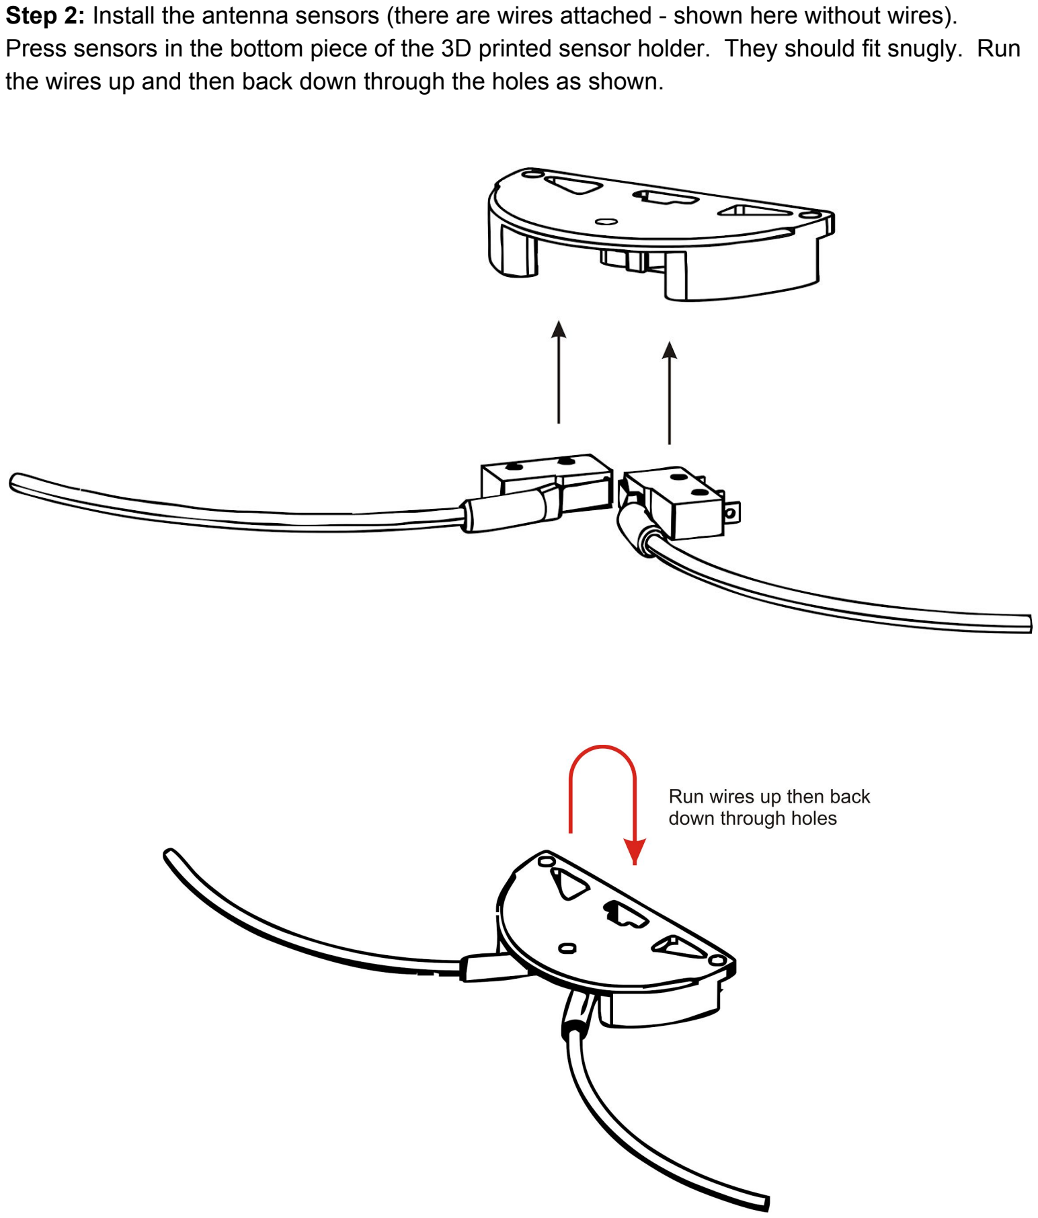
[picture p109: page 3]

Step | 2: | Install the antenna sensors (there are wires attached - shown here without wires).
Press sensors in the bottom piece of the 3D printed sensor holder. They should fit snugly. Run the wires up and then back down through the holes as shown.

Step | 3: | Attach the two 3D printed sensor holder pieces by aligning the top piece with the bottom
piece and running the 3 self-tapping screws up through the holes.

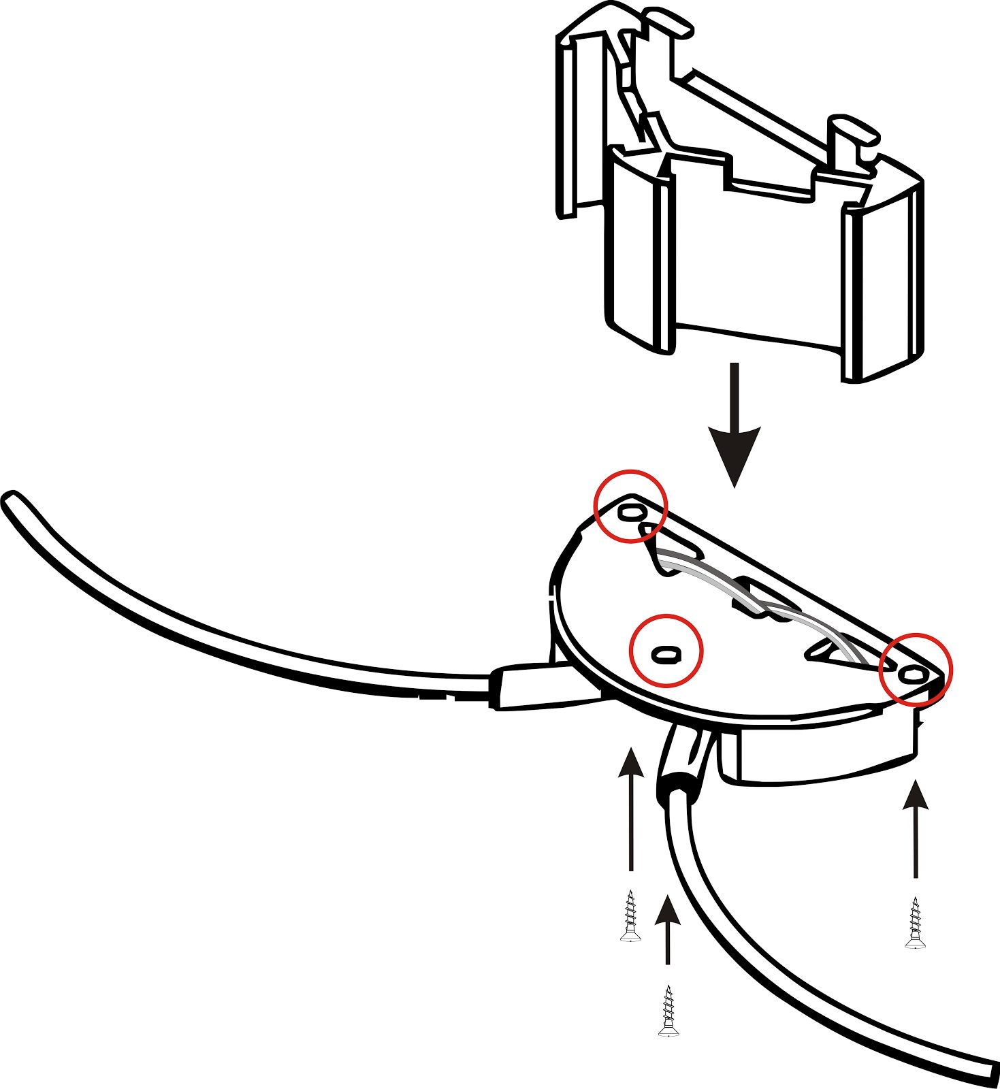
[picture p110: figure]

Step | 4: | Slide the two sensor blanks into the sensor mount as shown. Then run the wires from
the antenna sensors down through the hole of the assembled acrylic segment and through the holes of the segment supports.

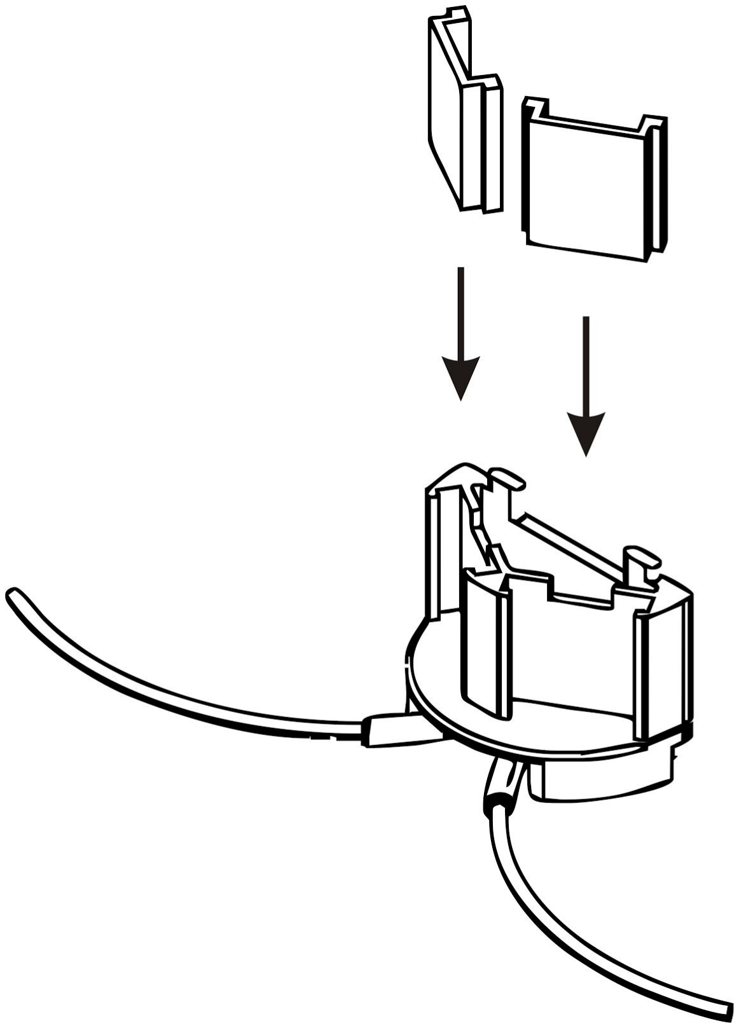
[picture p111: figure]
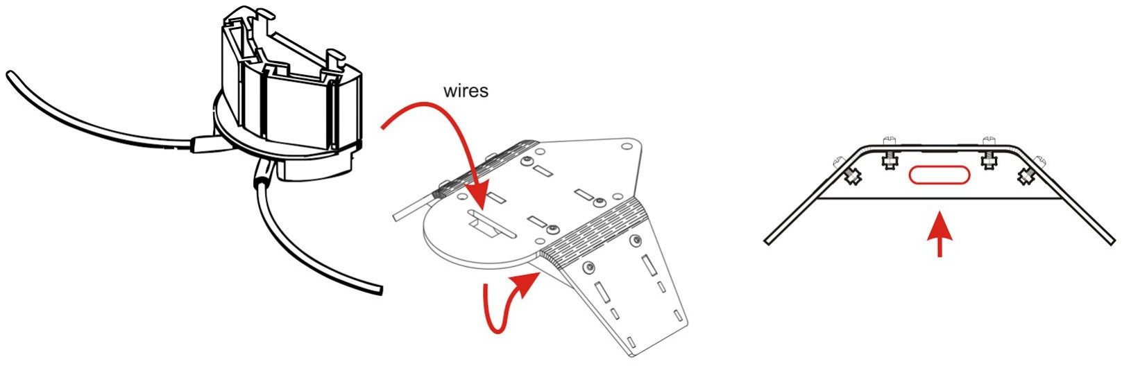
[picture p112: figure]

Step | 5: | Place the 9v holder on top of the assembled head segment and then place the head top
on the sensor mount and the 9v holder aligning all tabs. Run the 2” screws through the head top, the 9v holder and the head segment. Use the Keps nuts to secure all pieces together.

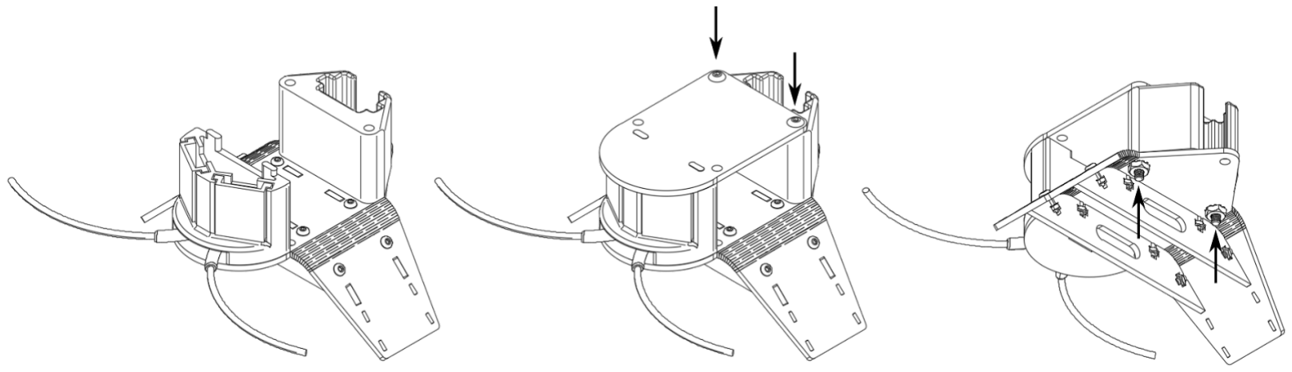
[picture p113: figure]
