Make-A-Pede/Make-A-Pede-Website/tutorials/manual/Instruction-Manual-Segment-Assembly.pdf

## Segment Assembly

Items required:

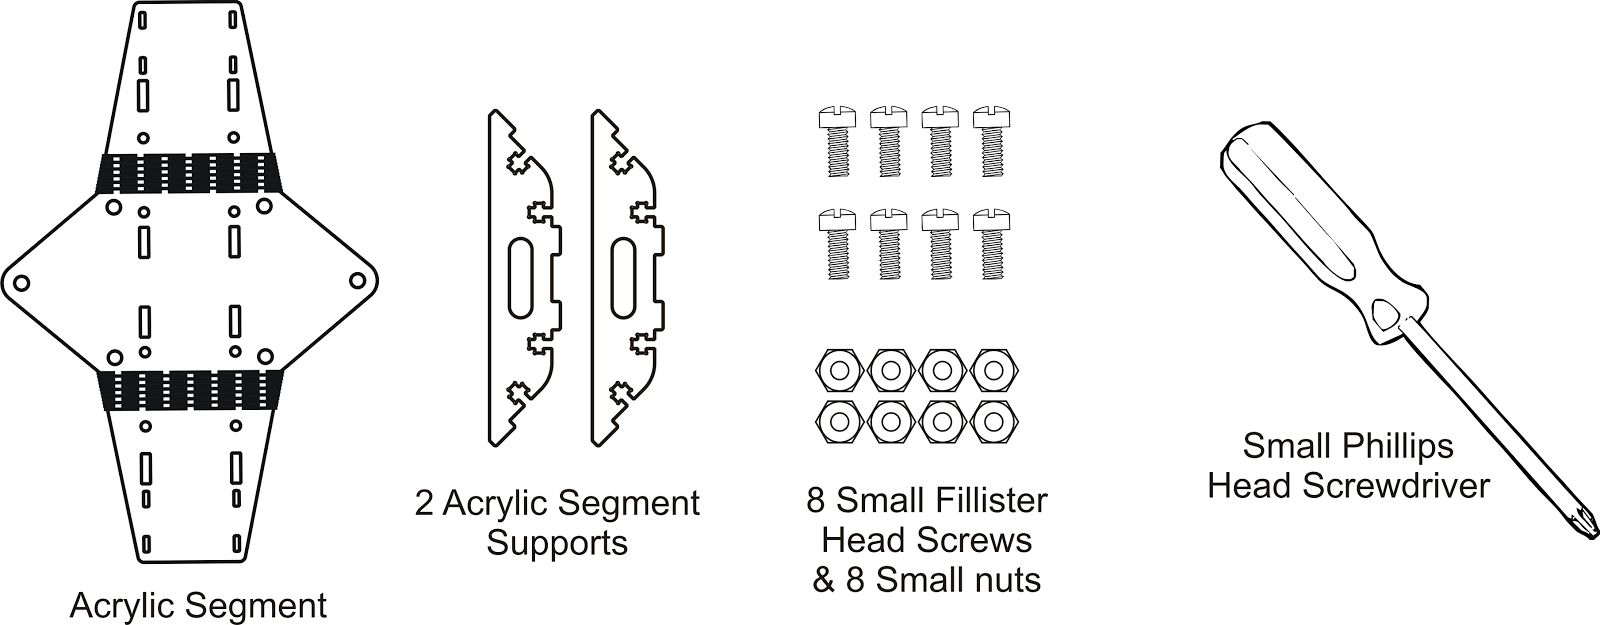
[picture p114: figure]

Step 1: The first step to putting together a segment is to remove all paper from the acrylic. Although this can be tedious, the paper is there to protect your acrylic from burning during laser cutting and scratching during shipping. It is best to lay the acrylic segment on a flat surface while removing the paper holding it firmly down with one hand while pulling the paper off with the other so as not to break the bendable portion of the acrylic. Caution: The acrylic segment is fragile until it is fully supported by the segment supports.

Step 2: Once all the paper is removed, begin assembly by inserting the tabs of one of the segment supports into the slots of the segment. Attach the two pieces together with the screws and nuts provided as shown below. Finger tighten the screws only. Repeat for second support.

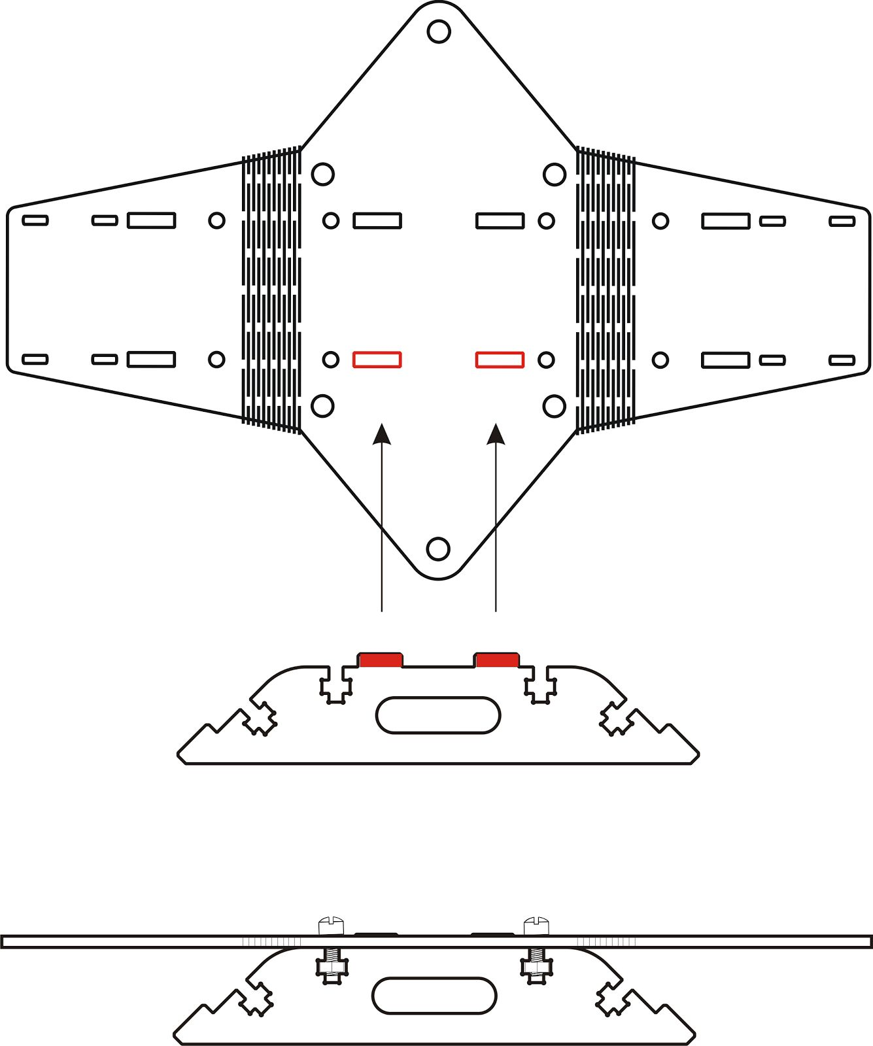
[picture p115: figure]

Step 3: Carefully bend one of the sides over the segment supports. Ensure that the tab on the end of the the support is properly inserted into the slot of the segment. Use screws and nuts to attach.

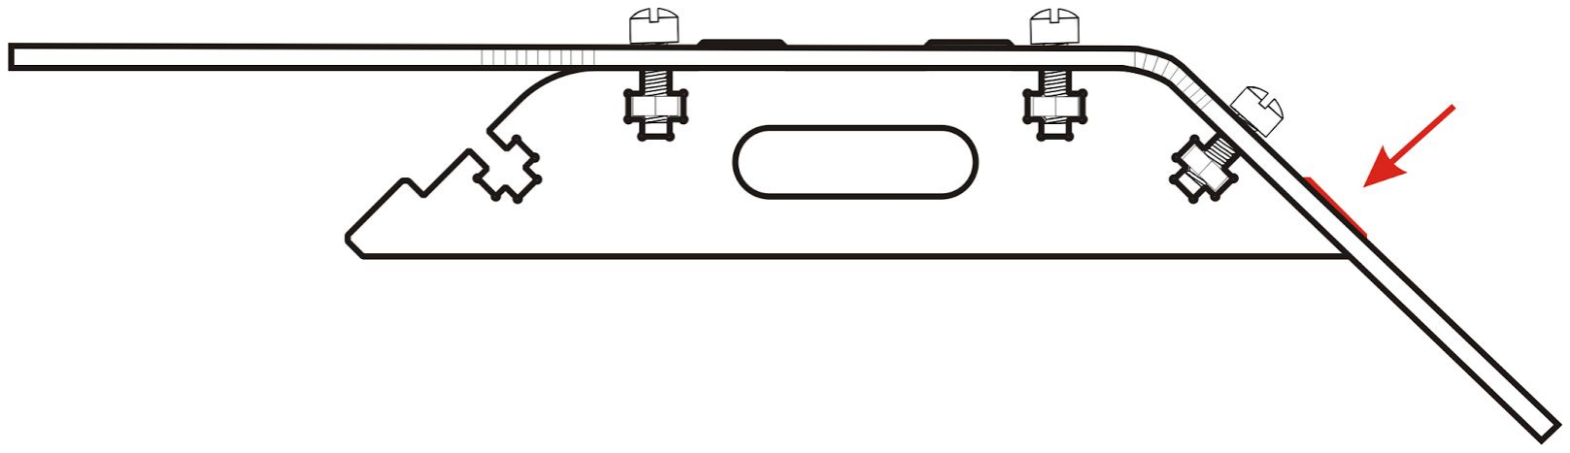
[picture p116: figure]

Step 4: Bend the second side over the support and use screws and nuts to attach. Tighten all screws with screwdriver until snug. Be careful not to overtighten.

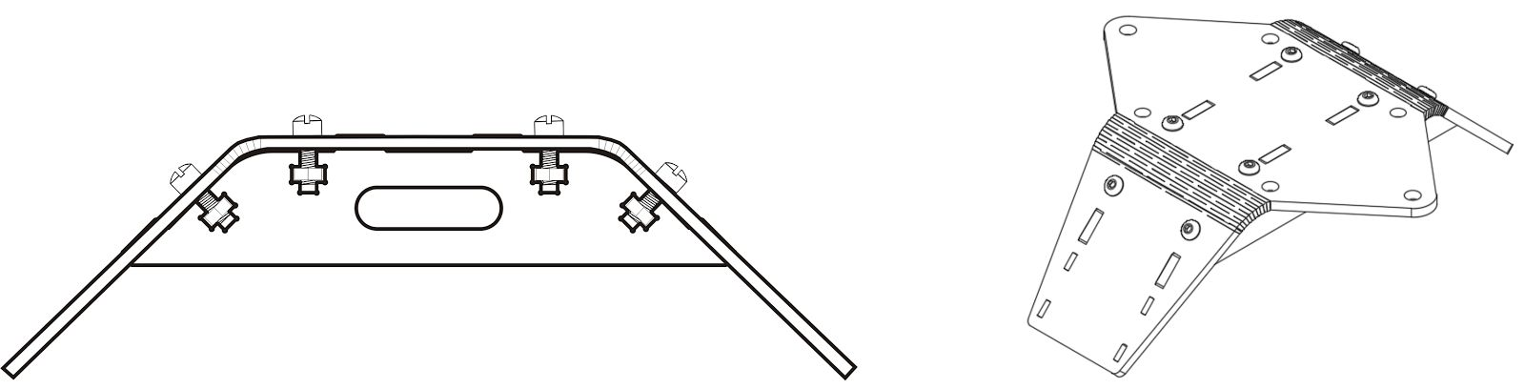
[picture p117: figure]

Repeat this process for all 4 body segments.

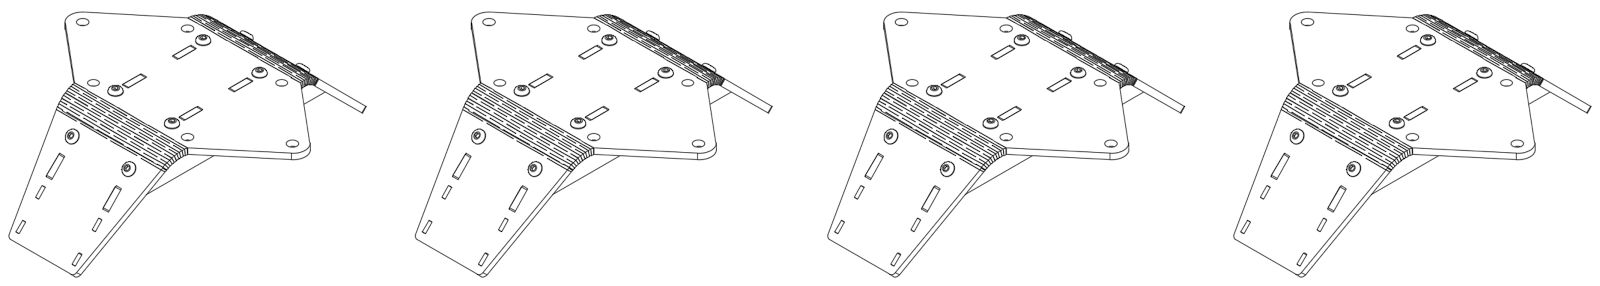
[picture p118: figure]
