Make-A-Pede/Make-A-Pede-Website/tutorials/manual/Instruction-Manual-String-Segments-Together.pdf

## String Segments Together

Items required:

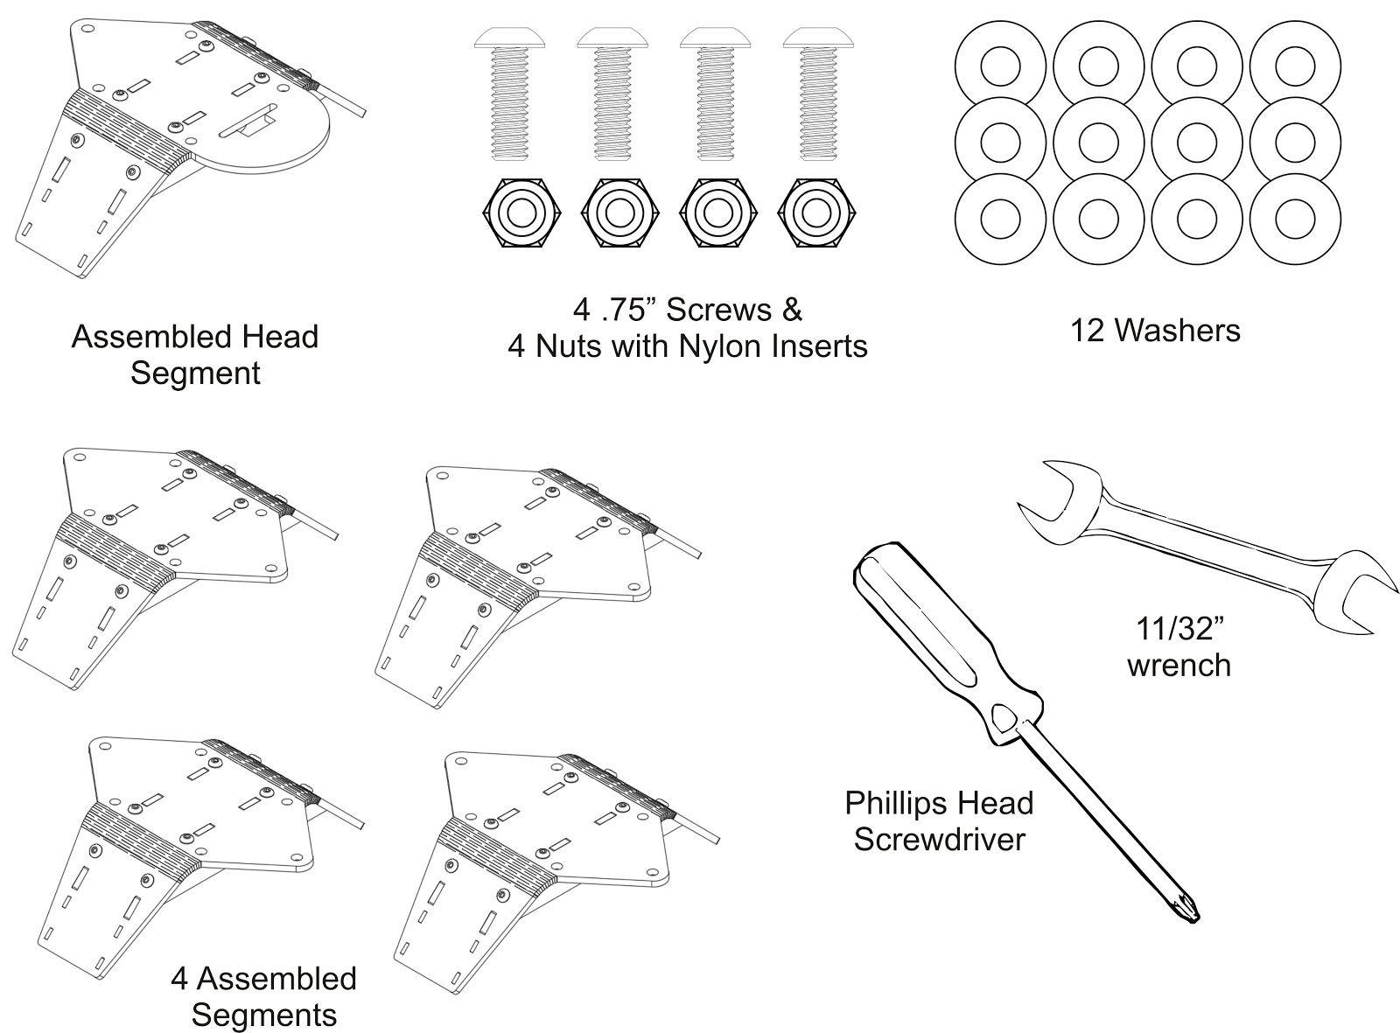
[picture p134: figure]

Step 1: Align screw holes of two segments. Using 3 washers, a .75” screw, and a nut with nylon insert, attach as shown below. Tighten until snug then back the nut off a half turn to allow for easy swiveling.

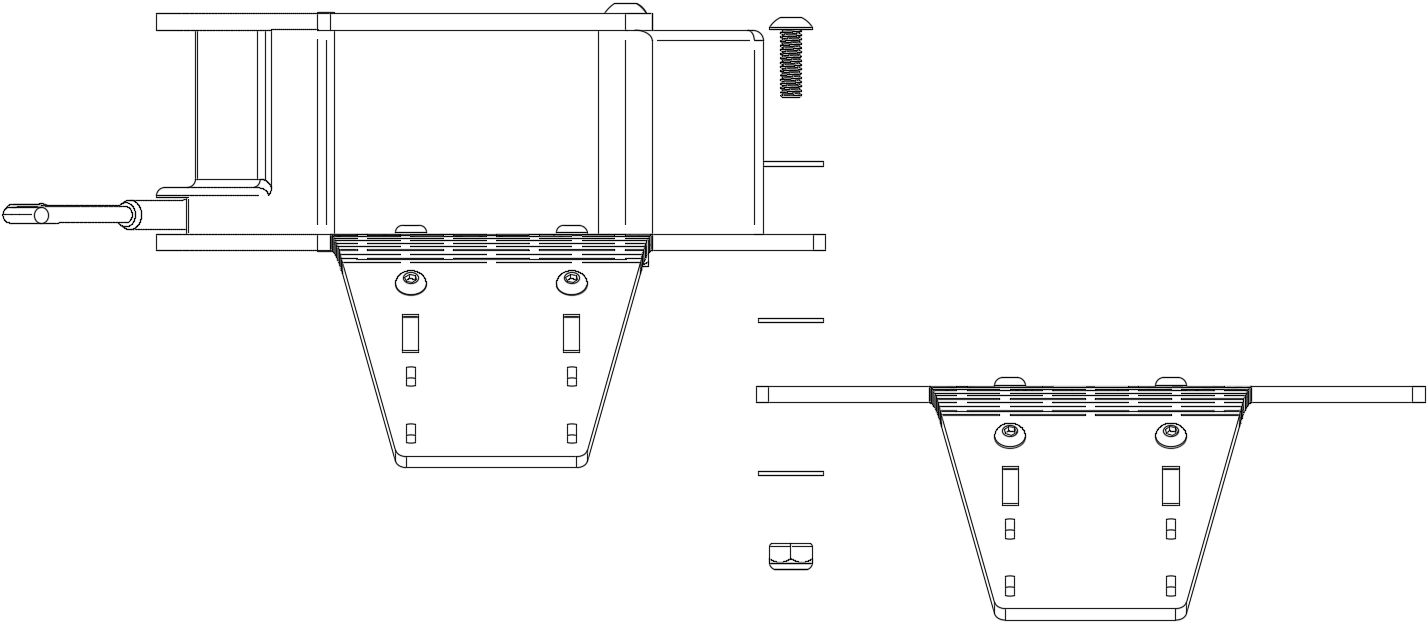
[picture p135: figure]

Step 2: Repeat process for 3 remaining joints.

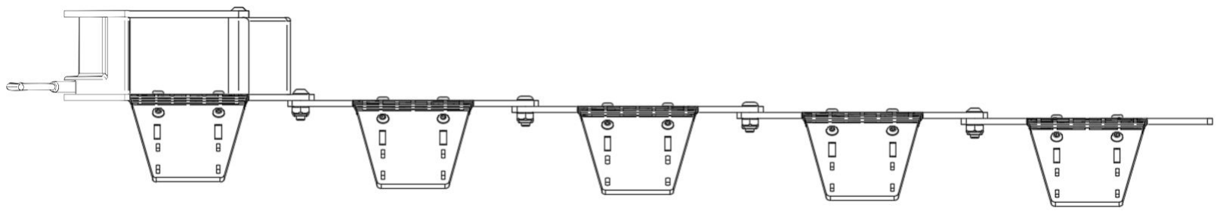
[picture p136: figure]
