Make-A-Pede/Make-A-Pede-Website/img/building.png

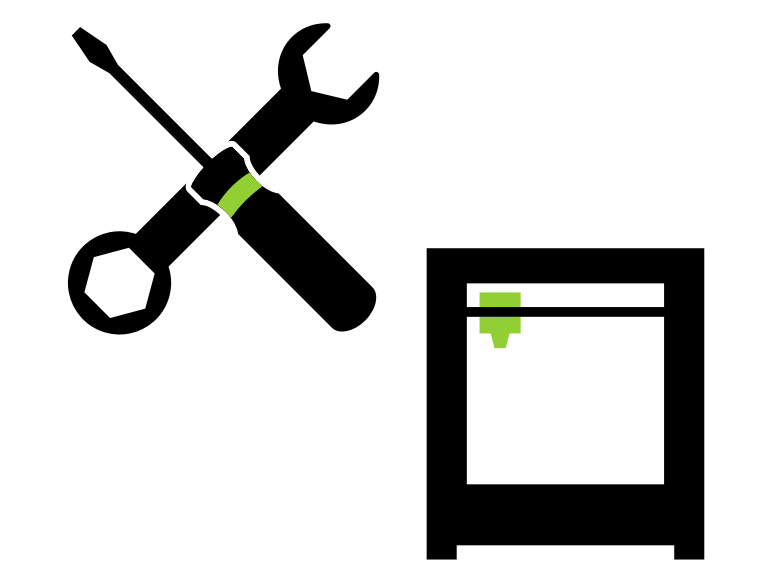
img/building.png
