Make-A-Pede/Make-A-Pede-Website/starthere/img/construction2.jpg

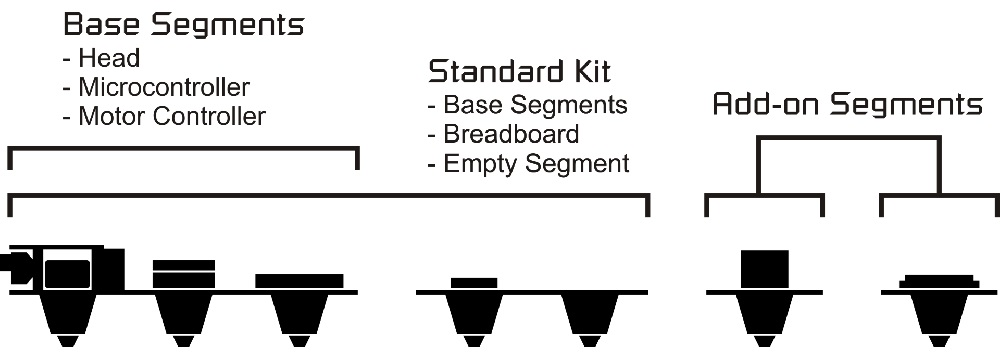
starthere/img/construction2.jpg
