Make-A-Pede/Make-A-Pede-Website/tutorials/installation-screenshots/1.jpg

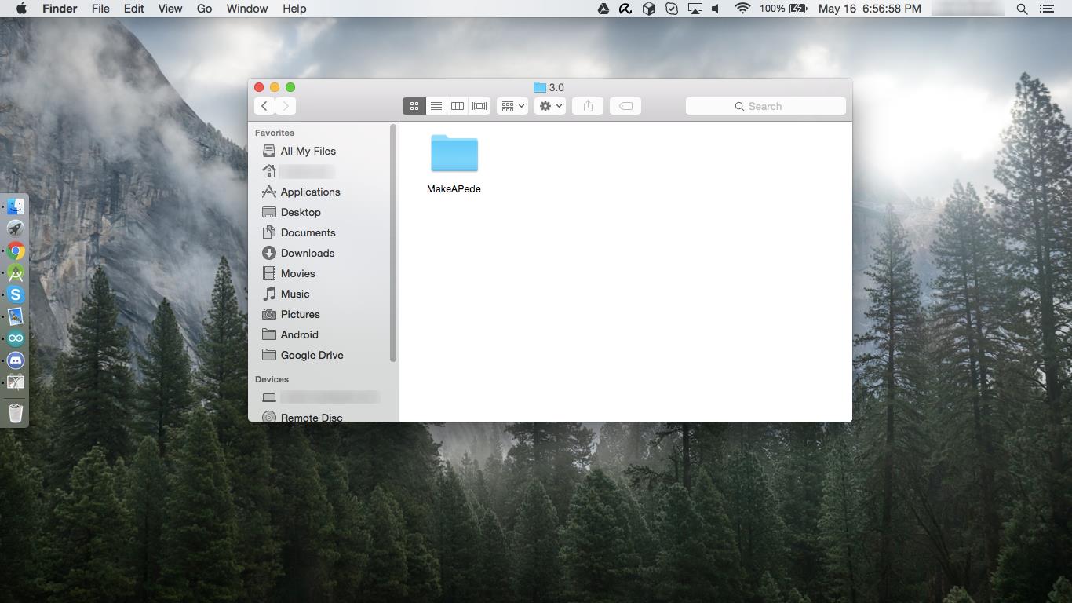
tutorials/installation-screenshots/1.jpg
