Make-A-Pede/Make-A-Pede-Website/tutorials/installation-screenshots/2.jpg

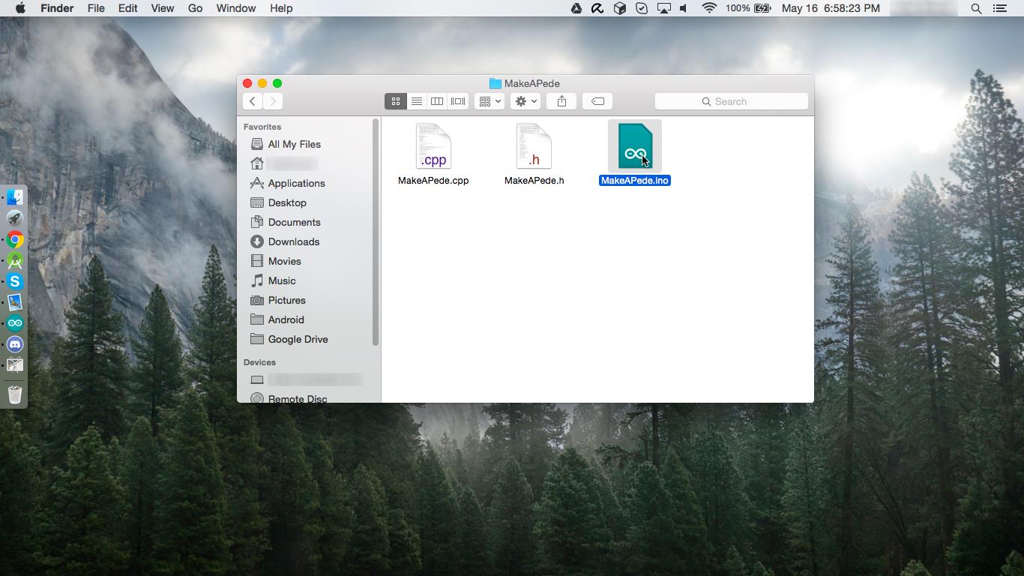
tutorials/installation-screenshots/2.jpg
