Make-A-Pede/Make-A-Pede-Website/buildyourownrobot/instruction-sheet-v3.pdf

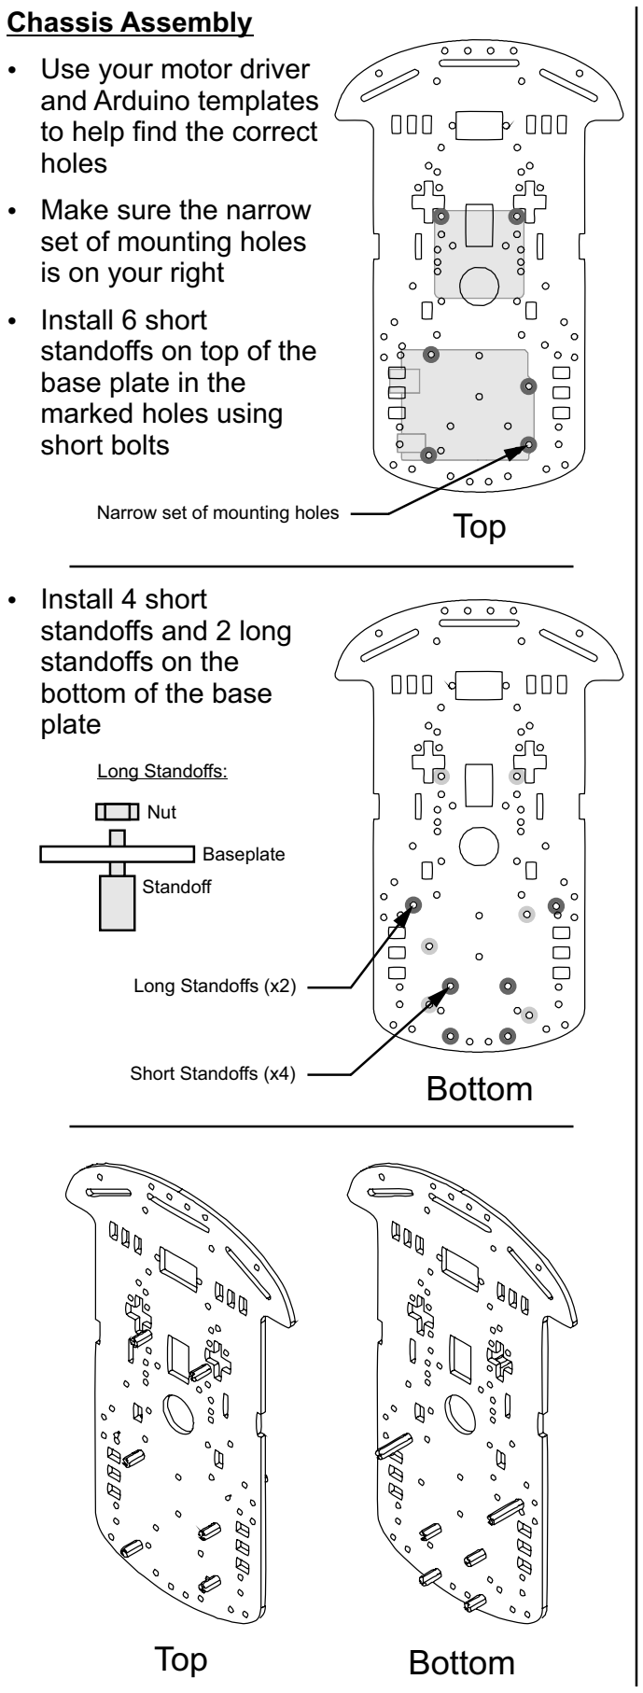
[picture p141: figure]
Top; Bottom; Chassis Assembly; Ÿ Use your motor driver and Arduino templates to help find the correct holes; Ÿ Make sure the narrow set of mounting holes is on your right; Ÿ Install 6 short standoffs on top of the base plate in the marked holes using short bolts; Ÿ Install 4 short standoffs and 2 long standoffs on the bottom of the base plate; Long Standoffs (x2); Short Standoffs (x4); Nut; Baseplate; Standoff; Long Standoffs:; Narrow set of mounting holes

Ÿ Slide one of the T-shaped plastic pieces through one of the slots in the base as shown

Ÿ Add a motor and second T using two long bolts and nuts
Ÿ Repeat for the other side

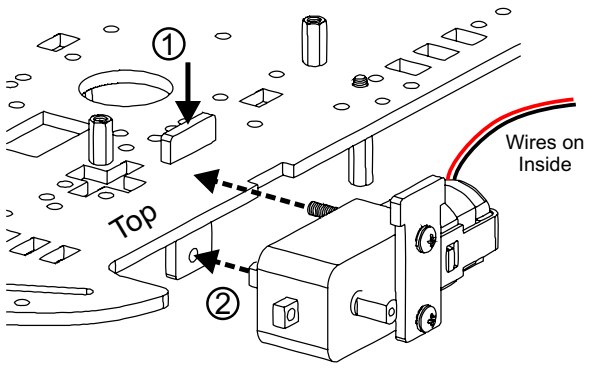
[picture p142: figure]
Top; Wires on Inside

Ÿ Press a wheel onto each motor
Ÿ Make sure the flat sections on the motor shaft line up with the flat sections on the wheel shaft

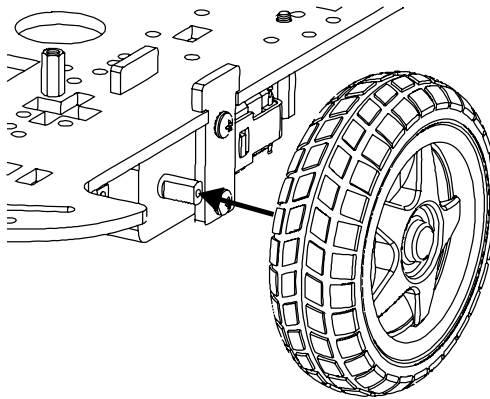
[picture p143: figure]
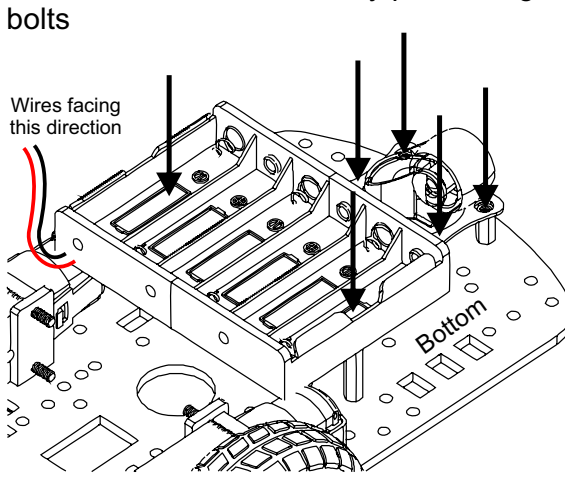
[picture p144: figure]
bolts; Bottom; Wires facing this direction

Ÿ Install the caster and battery pack using short

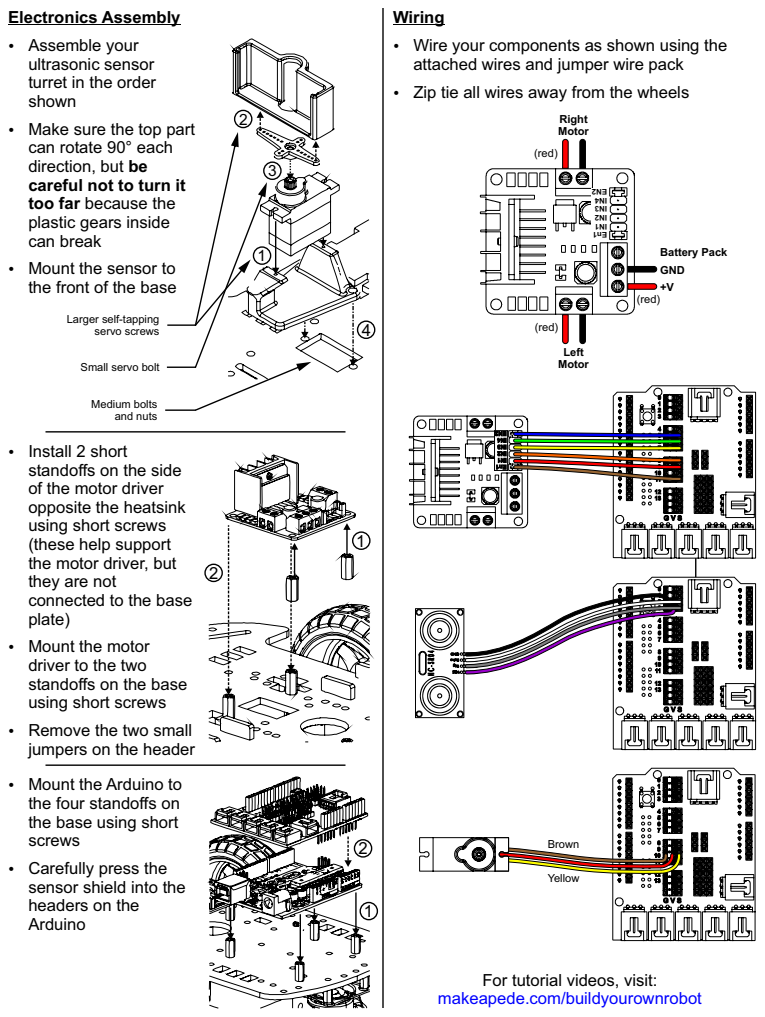
[picture p145: page 2]
Right Motor; Left Motor; Battery Pack; GND; Medium bolts and nuts; (red); Yellow; Brown

Electronics Assembly
Ÿ Assemble your
ultrasonic sensor
turret in the order
shown
Ÿ Make sure the top part
can rotate 90° each
direction, but be
careful not to turn it
too far because the
plastic gears inside
can break
Ÿ Mount the sensor to
the front of the base

Wiring
Ÿ Wire your components as shown using the
attached wires and jumper wire pack
Ÿ Zip tie all wires away from the wheels

Larger self-tapping
servo screws

Small servo bolt

Ÿ Install 2 short
standoffs on the side
of the motor driver
opposite the heatsink
using short screws
(these help support
the motor driver, but
they are not
connected to the base
plate)
Ÿ Mount the motor
driver to the two
standoffs on the base
Ÿ Remove the two small
jumpers on the header

Ÿ Mount the Arduino to
the four standoffs on
the base using short
screws
Ÿ Carefully press the
sensor shield into the
headers on the
Arduino

For tutorial videos, visit:
makeapede.com/buildyourownrobot
