Make-A-Pede/Make-A-Pede-Website/plans/MaP-Controller-v1.2.0.pdf

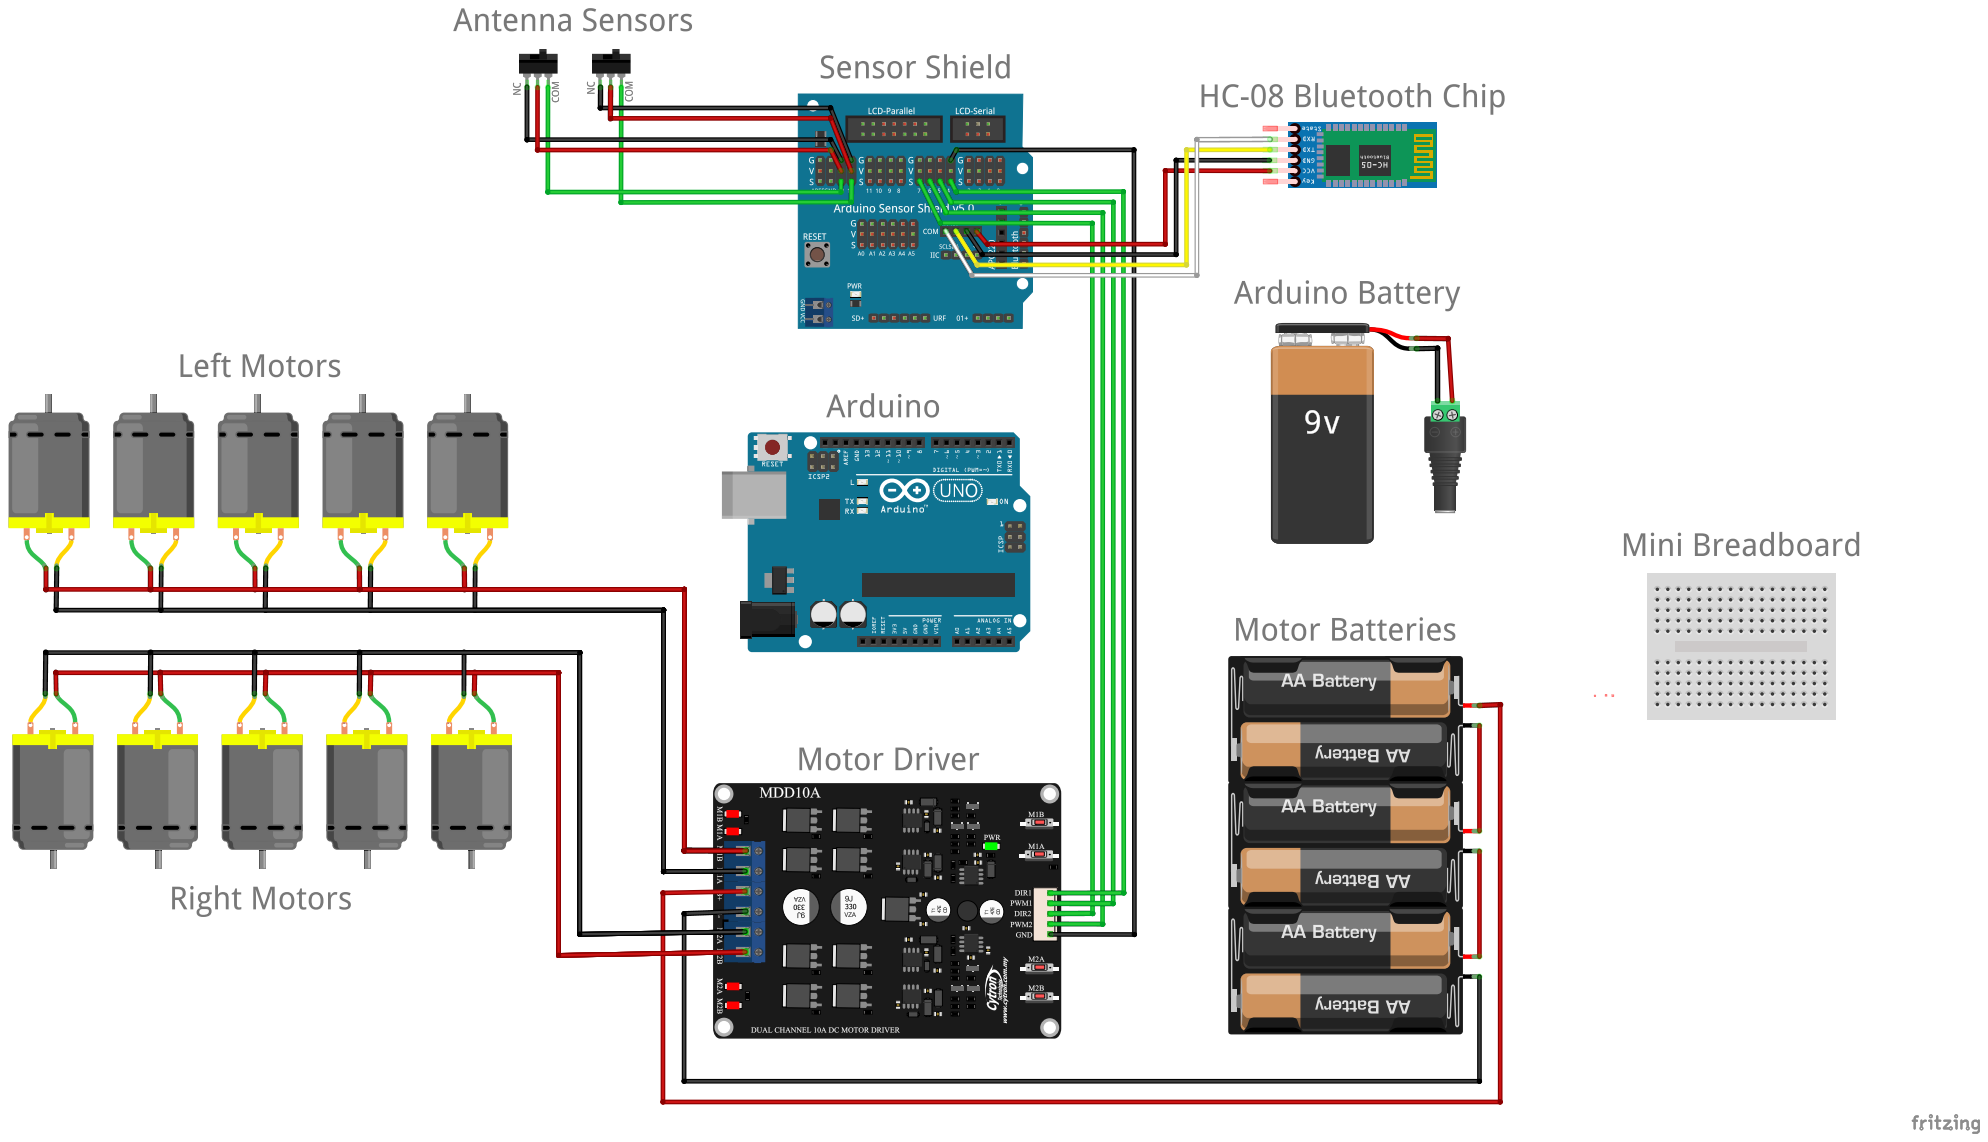
[picture p146: page 1]
