Make-A-Pede/Make-A-Pede-Website/plans/MaP-Controller-v1.1.0.pdf

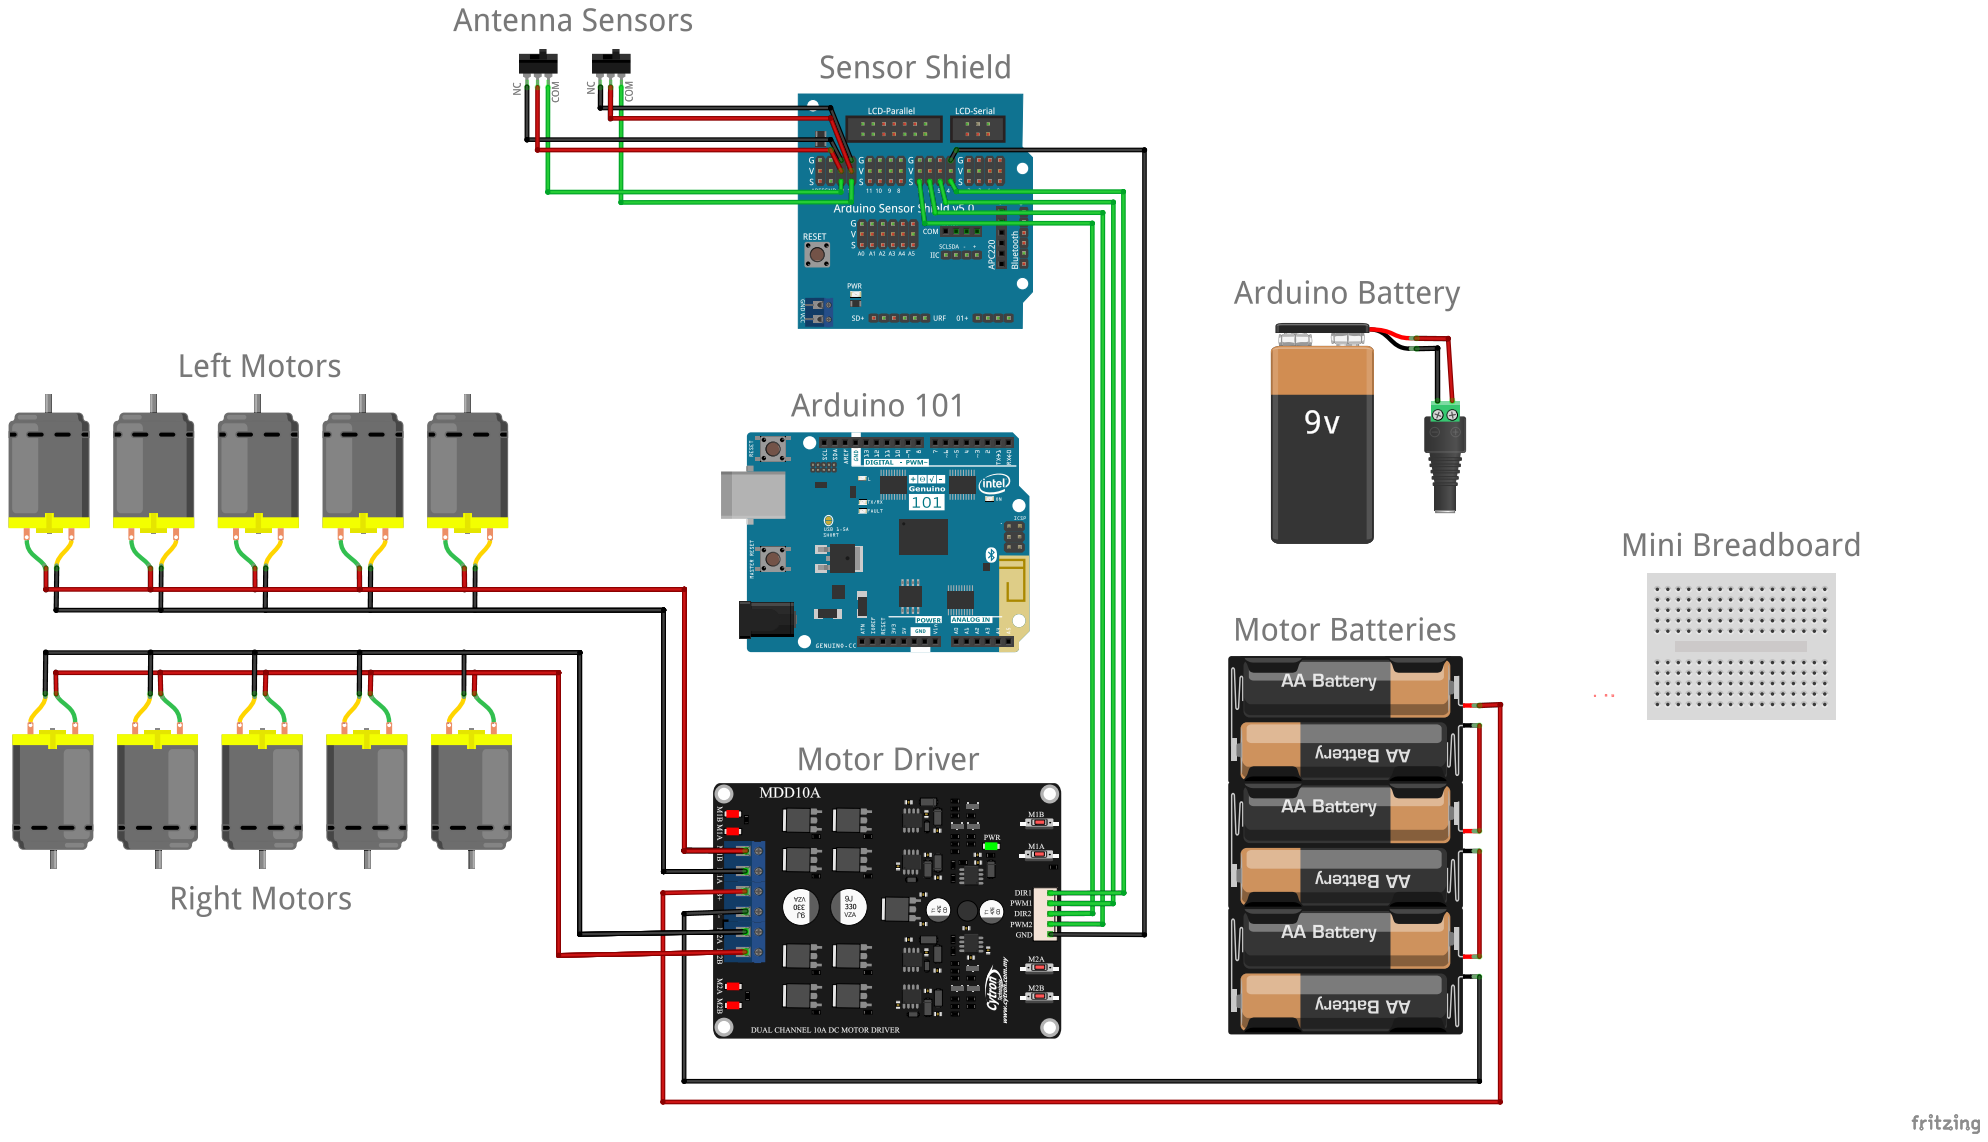
[picture p147: page 1]
