Make-A-Pede/Make-A-Pede-Website/(list of files, drawings)

Other design files:
plans/MaP-Controller-v1.1.0.fzz
plans/MaP-Controller-v1.2.0.fzz
