Make-A-Pede/Make-A-Pede-Website/(commit log)

2017-06-17 Initial Release
    [12x12-layout-1.dxf, 12x12-layout-2.dxf, 12x24-layout.dxf, MaP-9V-Holder v10.iges, MaP-9V-Holder v10.step, MaP-9V-Holder v10.stl, MaP-9V-Holder v8.iges, MaP-9V-Holder v8.step]
2017-06-28 Migrated design files to GitHub
    [12x12-layout-1.dxf, 12x12-layout-2.dxf, 12x24-layout.dxf, MaP-9V-Holder v10.iges, MaP-9V-Holder v10.step, MaP-9V-Holder v10.stl, MaP-9V-Holder v8.iges, MaP-9V-Holder v8.step]
2017-07-10 Content updates, fixed scrolling issue
    [MaP-Controller-v1.1.0.fzz]
2017-07-20 Added PIR sensor tutorial
2017-08-07 Updates to graphics
    [MaP-Controller-v1.2.0.fzz]
2017-08-24 Updated build modules and segment assembly
2018-06-01 Updated status LED tutorial
2018-06-07 Updated status LED tutorial PDF
2018-07-04 Added two tutorials
    - IR Distance Sensor
    - Color Sensor
2018-07-10 Added OLED eyes tutorial, updated color and distance sensor tutorials
2018-07-12 Updates to manual
    Added additional notes to awl step of "Run Wire and Install Motors"
